Pinocchio01/AutoCAD/README.md

# AutoCAD
Some computer aided design(CAD) works collected.
