Pinocchio01/AutoCAD/机械设计实习/机械设计任务书-1551663-彭义超.docx

机械设计课程设计

计算说明书

设计题目 圆锥圆柱齿轮减速器

机械与能源工程学院

专业 机械莱茵 学号 1551663

设计人_______ _彭义超_________

指导教师_ _奚鹰教授__ _ __

2018年7月18日

装 订 线 | 设计计算及说明 | 主要结果

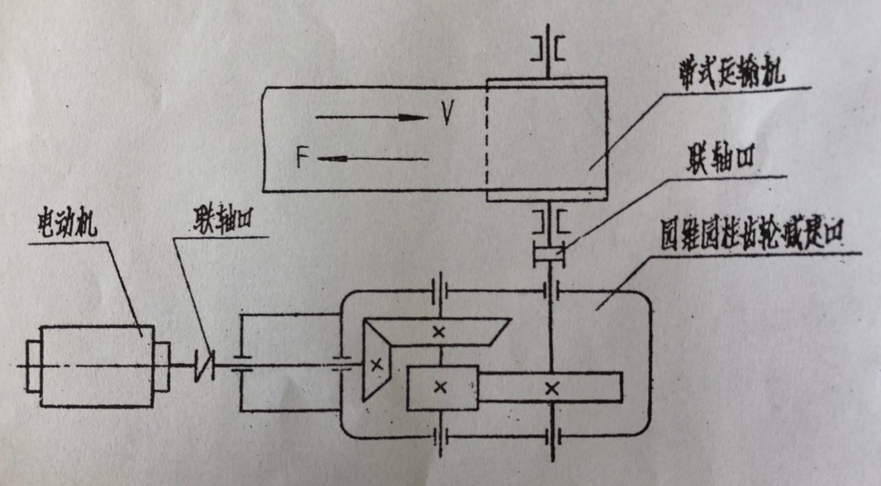
[picture p1: figure]

| 1 设计任务书 设计一个用于带式运输机上的圆锥圆柱齿轮减速器。总体布置简图如图 1.1所示。 图 1.1 总体布置简图 工作平稳、单向运转。所给原始数据如下表所示。 题号 运输带工作拉力F 运输带工作速度V 运输机卷筒直径D 带速允许偏差 使用期限 工作制度 3 2200 1.4 320 5 10 1 N m/s mm % 年 班/日 2 电动机选择 由所给定的条件可知，电动机选Y型。工作机主动轴的输出功率 P_ω =Fv=3.08kW 。根据运输带速度及卷筒的直径可知，输出转速为 n_w =(60×1000v_w)/(πD)=83.6 r/min 根据《机械设计课程设计》表 2-4，弹性联轴器、闭式圆柱齿轮传动、闭式圆锥齿轮传动、带式运输机以及滚动轴承的效率分别为0.99、0.97、0.95、0.99、0.95。所以电动机至工作机主动轴之间的总效率为 | P_ω =3.08 kW n_w =83.6 r/min

η_Σ =0.83 。所以电动机的输出功率为

P_d =(P_w)/(η_Σ)=3.71 kW

所以，选择电动机的型号为Y132M1-6。其额定功率为4 kW，满载转速为960 r/min。

电动机型号 | 额定功率 | 满载转速 | 额定转矩/ 额定转矩 | 最大转矩/ 额定转矩 | 质量
| 4 | 960 | 2.0 | 2.2 | 73
Y132M1-6 | kW | r/min | | | kg

# 3 传动比分配

由电动机的满载转速nm和工作机轴的转速nw可确定传动装置的总传动比为

i=(n_m)/(n_w)=i_1 i_2 =11.484

对于圆锥-圆柱齿轮减速器，为使大齿轮直径不致过大，高速级圆锥齿轮传动比取为

i_1 = 0.25i = 2.871 < 3，则两级圆柱齿轮传动的传动比为 i_2 =(i_Σ)/(i_1)=4 。定为： i_1 =2.8 , i_2 =4.1

由此，可以算出各轴的转速如下（以下标1表示输入轴的参数，下标2表示中间轴的参数，下标3表示输出轴的各参数）。

n_1 =n_m =960 r/min

n_2 =(n_1)/(i_1)=342.9 r/min

n_3 =(n_2)/(i_2)=83.6 r/min

各轴的功率如下。

P_1 =P_d η_01 =3.636 kW

P_2 =P_1 η_12 =3.420 kW

P_3 =P_2 η_23 =3.284 kW

各轴的输出转矩如下。

T_d =9550(P_d)/(n_m)=36.91 N∙m

T_1 =9550(P_1)/(n_1)=36.17 N∙m

T_2 =9550(P_2)/(n_2)=95.25 N∙m

T_3 =9550(P_3)/(n_3)=375.15 N∙m

计算结果汇总如下表所示。

项目 | 电动机轴 | | 1轴 | | 2轴 | | 3轴
转速 r/min | 960 | | 960 | | 342.9 | | 83.6
功率 kW | 11 | | 10.45 | | 10.04 | | 9.64
转矩 N∙m | 35.85 | | 68.12 | | 367.81 | | 1984.95
效率 | | 0.98 | | 0.94 | | 0.96

P_d =3.71 kW

P_(ed) =4 kW

n_m =960 r/min

i=11.484

i_1 =2.8

i_2 =4

n_1 =960r/min

n_2 =342.9r/min

n_3 =83.6r/min

P_1 =3.636kW

P_2 =3.420kW

P_3 =3.284kW

T_d =36.91N·m

T_1 =36.17N·m

T_2 =95.25N·m

T_3 =375.15N·m

# 4 齿轮的设计

## 4.1 斜齿圆柱齿轮的类型、精度等级、材料及齿数

低速齿轮传动选用斜齿圆柱齿轮传动，压力角取20°。带式输送机为一般工作机器，参考《机械设计》表 10-6，选用7级精度。由《机械设计》表 10-1，选择小齿轮材料为40Cr（调质），齿面硬度（265- 285）HBS，大齿轮材料为45钢（调质），齿面硬度（235- 255）HBS。选小齿轮齿数z1= 24，则大齿轮齿数z2= uz1= 98.4，取z2= 98。初选螺旋角 β=14° 。

## 4.2 按齿面接触疲劳强度计算

计算小齿轮的分度圆直径，即

d_(1t) ≥³√((2K_(Ht) T_1)/(ϕ_d)∙(u+1)/u∙((Z_H Z_E Z_ε Z_β)/([σ_H ]))^2)

确定公式中各参数的值如下。

①试选载荷参数 K_(Ht) =1.3 。

②由《机械设计》图 10-20查取区域系数 Z_H =2.433

③计算接触疲劳强度用重合度系数 Z_ε

α_t =arctan⁡(tanα_n /cosβ)=20.562°

α_(at1) =arccos[z_1 cosα_t /(z_1 +2h_(an)^(*) cosβ)]=29.974°

α_(at2) =arccos[z_2 cosα_t /(z_2 +2h_(an)^(*) cosβ)]=23.038°

ε_α =[z_1 (tanα_(at1) -tanα_t^(') )+z_2 (tanα_(at2) -tanα_t^(') )]/2π=1.552

ε_β =ϕ_d z_1 tanβ/π=2.096

Z_ε =√((4-ε_α)/3(1-ε_β )+(ε_β)/(ε_α))=0.675

④螺旋角系数

Z_β =√(cosβ)=0.985

⑤根据《机械设计》表 10-7选取齿宽系数 ϕ_d =1 .1

⑥根据《机械设计》表 10-5查得材料的弹性影响系数 Z_E =189.8 MPa^(1/2)

⑦计算接触疲劳需用应力 [σ_H ]

根据《机械设计》图 10-25d查得小齿轮和大齿轮的接触疲劳极限分别为 σ_(Hlim1) =600 MPa 、 σ_(Hlim2) =550 MPa 。

应力循环次数为

N_1 =60n_1 jL_h =4.939×10^8

N_2 =N_1 /u=1.2×10^8

由《机械设计》图 10-23查得接触疲劳寿命系数 K_(HN1) =0.93 、 K_(HN2) =0.97 。取失效概率为1%、安全系数S=1，所以

[σ_H ]_1 =(K_(HN1) σ_(Hlim1))/S=558 MPa

[σ_H ]_2 =(K_(HN2) σ_(Hlim2))/S=534 MPa

取 [σ_H ]_1 和 [σ_H ]_2 中的较小者作为该齿轮副的接触疲劳许用应力，即 [σ_H ]=534 Mpa 。

所以小齿轮分度圆直径 d_(1t) ≥48.088 mm 。

由此可得，圆周速度为

v=(πd_(1t) n_1)/(60×1000)=0.93 m/s

齿宽为

b=ϕ_d d_(1t) =52.896 mm

由《机械设计》表 10-2查得使用系数 K_A =1.25 ，根据圆周速度0.93m/s及7级精度，由图 10-8查得动载系数 K_v =1.03 ，齿轮的圆周力 F_(t1) =2T_1 /d_(1t) =3.962×10^3 N ， K_A F_(t1) /b=93.63 N/mm<100 N/mm ，查表 10-3得齿间载荷分布系数 K_(Hα) =1.4 。由表 10-4用外插法查得齿向载荷分布系数 K_(Hβ) =1.485 ，所以，载荷系数为

K_H =K_A K_v K_(Hα) K_(Hβ) =2.677

则按实际载荷系数算得的分度圆直径为

d_1 =d_(1t) ³√((K_H)/(K_(Ht)))=61.179 mm

相应的齿轮模数为

m_n =d_1 cosβ/z_1 =2.473 mm

4.3 按齿根弯曲强度设计

试算齿轮模数得

m_(nt) ≥³√((2K_(Ft) T_1 Y_ε Y_β cos^2 β)/(ϕ_d z_1^2)∙[(Y_(Fa) Y_(sa))/([σ_F ])])

①试选载荷系数 K_(Ft) =1.3

②计算弯曲疲劳强度的重合度系数 Y_ε

β_b =arctan(tanβcosα_t )=13.140°

ε_(αv) =ε_α /cos^2 β_b =1.637

Y_ε =0.25+0.75/ε_(αv) =0.708

③计算弯曲疲劳强度的螺旋角系数 Y_β

Y_β =1-ε_β β/(120°)=0.778

④计算 (Y_(Fa) Y_(sa))/([σ_F ])

由当量齿数

z_(v1) =z_1 /cos^3 β=26.27

z_(v2) =z_2 /cos^3 β=107.28

查《机械设计》图 10-17，得齿形系数 Y_(Fa1) = 2.62、 Y_(Fa2) =2.18 。由图 10-18查得应力修正系数 Y_(sa1) =1.6 、 Y_(sa2) = 1.81。由图 10-24c查得小齿轮和大齿轮的齿根弯曲疲劳极限分别为 σ_(Flim1) =500 MPa 、 σ_(Flim2) =380 MPa 。由图 10-22查得弯曲疲劳寿命系数 K_(FN1) =0.92 ， K_(FN2) =0.96 。取弯曲疲劳安全系数S=1.4，得

[σ_F ]_1 =(K_(FN1) σ_(Flim1))/S=328.57 MPa

[σ_F ]_2 =(K_(FN2) σ_(Flim2))/S=260.57 MPa

(Y_(Fa1) Y_(sa1))/([σ_F ]_1)=0.0128

(Y_(Fa2) Y_(sa2))/([σ_F ]_2)=0.0151

故取

(Y_(Fa) Y_(sa))/([σ_F ])=0.0151

所以齿轮模数 m_(nt) ≥1.453 mm 。

d_1 =m_(n1) z_1 /cosβ=35.940 mm

v=(πd_1 n_1)/(60×1000)=0.65 m/s

b=ϕ_d d_1 =39.534 mm

h=(2h_(an)^(*) +c_n^(*) )m_(nt) =3.269 mm

b/h=12.09

根据圆周速度及7级精度，由《机械设计》图 10-8，查得动载系数 K_v =1.01 ，由 F_(t1) =2T_1 /d_1 =5.203×10^3 N ， K_A F_(t1) /b=158.80 N/mm>100 N/mm ，查表 10-3得齿间载荷分配系数 K_(Fα) =1.2 ，由表 10-4查得齿向载荷分布系数 K_(Hβ) =1.370 ，结合b/h=12.09查图 10-13，得 K_(Fβ) =1.32 ，故载荷系数为

K_F =K_A K_v K_(Fα) K_(Fβ) =2.039

所以按实际载荷系数算得的齿轮模数为

m_n =m_(nt) ³√((K_F)/(K_(Ft)))=1.688 mm

对比计算结果，由齿面接触疲劳强度计算的法面模数mn大于由齿根弯曲疲劳强度计算的法面模数。从满足弯曲疲劳强度出发，从标准中就近取mn=2 mm；为了同时满足接触疲劳强度，需按接触疲劳强度算得的分度圆直径 d_1 =61.179 mm 来计算小齿轮的齿数，即 z_1 =d_1 cosβ/m_n =29.7 ，取 z_1 =29 ，则 z_2 =uz_1 =118.9 ，取 z_2 =119 ，z1与z2互为质数。

## 4.4 几何尺寸计算

①计算中心距

a=((z_1 +z_2 )m_n)/(2cosβ)=152.31 mm

考虑模数从1.688 mm增大圆整至2 mm，为此将中心距减小圆整为150 mm。

②按圆整后的中心距修正螺旋角

β=arccos((z_1 +z_2 )m_n)/(2a)=11.48°

③计算小、大齿轮的分度圆直径

d_1 =(z_1 m_n)/(cosβ)=59.18 mm

d_2 =(z_2 m_n)/(cosβ)=240.82 mm

④计算齿轮宽度

b=ϕ_d d_1 =65.1 mm

取 b_2 =65 mm 、 b_1 =70 mm 。

## 4.5 圆整中心距后的强度校核

### 4.5.1 齿面接触疲劳强度校核

σ_H =√((2K_H T_1)/(ϕ_d d_1^3)∙(u+1)/u)Z_H Z_E Z_ε Z_β

①计算载荷系数 K_H

取使用系数 K_A =1.25 ，由

v=(πd_1 n_1)/(60×1000)=1.06 m/s

以及7级精度，由《机械设计》图 10-8查得动载系数 K_v = 1.06，齿轮的圆周力 F_(t1) =2T_1 /d_1 =3.218×10^3 N ， K_A F_(t1) /b=57.46 N/mm<100 N/mm ，查表10-3得齿间载荷分配系数 K_(Hα) =1.4 ，由表 10-4得齿向载荷分布系数 K_(Hβ) =1.439 ，所以载荷系数为

K_H =K_A K_v K_(Hα) K_(Hβ) =2.67

②计算区域系数 Z_H

由《机械设计》图 10-20查得区域系数 Z_H =2.45

③计算弹性影响系数 Z_E

由《机械设计》表 10-5查得材料的弹性影响系数 Z_E =189.8 MPa^(1/2)

④计算重合度系数 Z_ε

α_t =arctan⁡(tanα_n /cosβ)=20.562°

α_(at1) =arccos⁡[z_1 cosα_t /(z_1 +2h_(an)^(*) cosβ)]=29.131°

α_(at2) =arccos⁡[z_2 cosα_t /(z_2 +2h_(an)^(*) cosβ)]=23.065°

ε_α =[z_1 (tanα_(at1) -tanα_t^(') )+z_2 (tanα_(at2) -tanα_t^(') )]/2π=1.67

ε_β =ϕ_d z_1 tanβ/π=0.989

Z_ε =√((4-ε_α)/3(1-ε_β )+(ε_β)/(ε_α))=0.65

⑤计算螺旋角系数 Z_β

Z_β =√(cosβ)=0.99

综上可得， σ_H =498.9 MPa<[σ_H ]=534 MPa ，故满足齿面接触疲劳强度条件。

### 4.5.2 齿根弯曲疲劳强度校核

σ_F =(2K_F T_1 Y_(Fa) Y_(sa) Y_ε Y_β cos^2 β)/(ϕ_d m_n^3 z_1^2)

①计算载荷系数 K_F

K_A =1.25 ， K_v =1.06 ，由《机械设计》表 10-3查得齿间载荷分配系数 K_(Fα) =1.4 ，结合 h=(2h_(an)^(*) +c_n^(*) )m_(nt) =4.5 mm ， b/h=14.4 ，查图 10-13得 K_(Fβ) =1.45 ，所以载荷系数

K_F =K_A K_v K_(Fα) K_(Fβ) =2.68

②计算齿形系数 Y_(Fa)

由当量齿数

z_(v1) =z_1 /cos^3 β=30.8

z_(v2) =z_2 /cos^3 β=125.4

查《机械设计》图 10-17，得齿形系数 Y_(Fa1) =2.54 ， Y_(Fa2) =2.17 。

③计算应力修正系数 Y_(sa)

由《机械设计》图 10-18查得应力修正系数 Y_(sa1) =1.63 ， Y_(sa2) =1.83 。

④计算重合度系数 Y_ε

β_b =arctan(tanβcosα_t )=10.766°

ε_(αv) =ε_α /cos^2 β_b =1.730

Y_ε =0.25+0.75/ε_(αv) =0.684

⑤计算螺旋角系数 Y_β

Y_β =1-ε_β β/(120°)=0.905

综上可得

σ_(F1) =(2K_F T_1 Y_(Fa1) Y_(sa1) Y_ε Y_β cos^2 β)/(ϕ_d m_n^3 z_1^2)=169.8MPa<[σ_F ]_1

σ_(F2) =(2K_F T_1 Y_(Fa2) Y_(sa2) Y_ε Y_β cos^2 β)/(ϕ_d m_n^3 z_1^2)=162.9 MPa<[σ_F ]_2

所以齿根弯曲疲劳强度满足要求。

## 4.6 高速级直齿圆锥齿轮的设计

### 4.6.1选定齿轮类型、精度等级、材料及齿数

选用标准圆锥直齿轮传动，压力角取 20° 。根据参考文献[2]表10-6，通用减速器取精度等级7级。

由参考文献[2]表10-1，选择小齿轮材料为40Cr（调质），齿面硬度2（265- 285）HBS，大齿轮材料为45钢（调质），齿面硬度为（235- 255）HBS。

选小齿轮齿数 z_1 =24 ,大齿轮齿数 z_2 =z_1 i_1 =24×2.8=67.2 , 取 z_2 =67 。

α=20°

z_1 =24

z_2 =98

β=14°

σ_(Hlim1) =600 MP a

σ_(Hlim2) =550 MPa

[σ_H ]=534 Mpa

v=0.93 m/s

b=52.896 mm

d_1 =61.179 mm

m_n =2.473 mm

m_n =2

z_1 =29

z_2 =119

a=152.31mm

β=11.48°

d_1 =59.18mm

d_2 =240.82mm

b_1 =70 mm

b_2 =65 mm

α=20°

z_1 =24

z_2 =67

### 4.6.2按齿面接触强度设计

试算小齿轮分度圆直径

d_(1t) ≥³√((4K_(Ht) T_1)/(∅_R (1-0.5∅_R )^2 i_1)∙((Z_H Z_E)/([σ_H ]))^2)

#### 4.6.2.1 确定公式中各参数

试选 K_(Ht) =1.3

T1=3.617×10^4 Nmm

取齿宽系数 ∅_R =0.3

由参考文献[2]图10-20查得区域系数 Z_H =2.5

由参考文献[2]表10-5查得材料的弹性影响系数 Z_E =189.8

由参考文献[2]图10-25d查得小齿轮和大齿轮的接触疲劳极限分别为 σ_(Hlim1) =600Mpa ， σ_(Hlim1) =550Mpa 。

计算应力循环次数

N_1 =60n_1 jL_h =60×960×1×(1×8×300×10)=1.3824×10^9

N_2 =(N_1)/(i_1)=(1.3824×10^9)/2.8=4.937×10^8

由参考文献[2]图10-23查取接触疲劳寿命系数 K_(HN1) =0.95 , K_(HN2) =0.97 。取失效概率为1%，安全系数 S=1

[σ_H ]_1 =(K_(HN1) σ_(Hlim1))/S=(0.92×650)/1=570Mpa

[σ_H ]_2 =(K_(HN2) σ_(Hlim2))/S=(0.98×600)/1=534Mpa

取其中较小者作为接触疲劳许用应力，即

[σ_H ]=[σ_H ]_2 =534Mpa

#### 4.6.2.2 试算小齿轮分度圆直径

d_(1t) ≥³√((4K_(Ht) T_1)/(∅_R (1-0.5∅_R )^2 i_1)∙[(Z_H Z_E)/([σ_H ])]^2)

=³√((4×1.3×3.617×10^4)/(0.3×(1-0.5×0.3)^2 ×(67/24))×((2.5×189.8)/534)^2)

=62.649 mm

#### 4.6.2.3调整小齿轮分度圆直径

圆周速度v

d_(m1) =d_(1t) (1-0.5∅_R )=62.649×(1-0.5×0.3)=53.252 mm

v_m =(πd_(m1) n_1)/(60×1000)=(π×53.252×960)/(60×1000)=2.677 m/s

[σ_H ]=534MPa

当量齿轮的齿宽系数 ∅_d

b=∅_R d_(1t) (√(i_1 ^2 +1))/2=0.3×62.694×(√((67/24)^2 +1))/2=27.887mm

∅_d =b/(d_(m1))=24.735/46.118=0.524

由参考文献[2]表10-2查得使用系数 K_A =1.25

由参考文献[2]图10-8查得动载系数 K_v =1.1

齿间载荷分配系数 K_(Hα) =1

由参考文献[2]表10-4用插值法查得齿向载荷分布系数 K_(Hβ) =1.28

可以计算得实际载荷系数

K_H =K_A K_v K_(Hα) K_(Hβ) =1.25×1.1×1×1.28=1.762

按实际载荷系数算得的分度圆直径为

d_1 =d_(1t) ³√((K_H)/(K_(Ht)))=62.649×³√(1.76/1.3)=69.322mm

相应的齿轮模数为

m=(d_1)/(z_1)=69.322/24=2.889mm

### 4.6.3按齿根弯曲疲劳强度计算

m≥³√((K_(Ft) T_1)/(∅_R (1-0.5∅_R )^2 z_1 ^2 √(i_1 ^2 +1))∙(Y_(Fa) Y_(Sa))/([σ_F ]))

#### 4.6.3.1确定公式中的各参数值

试选 K_(Ft) =1.3

由分锥角 δ_1 =arctan(1/u)=arctan(24/67)=19.708° 和 δ_2 =90°-19.708°=70.292° ，可得当量齿轮数 z_(v1) =(z_1)/(cos⁡(δ_1 ))=24/(cos⁡(19.708°))=25.49 ， z_(v2) =(z_2)/(cos⁡(δ_2 ))=67/(cos⁡(70.292°))=198.68

由参考文献[2]图10-17查得齿形系数 Y_(Fa1) =2.67 ， Y_(Fa2) =2.15 。由参考文献[2]图10-18查得应力修正系数 Y_(Sa1) =1.60 ， Y_(Sa2) =1.83 。由参考文献[2]图10-24c查得小齿轮和大齿轮的齿根弯曲疲劳极限分别为 σ_(Flim1) =500Mpa ， σ_(Flim2) =380Mpa 。由参考文献[2]图10-22查得弯曲疲劳寿命系数 K_(FN1) =0.88 ， K_(FN2) =0.90 。取弯曲疲劳安全系数S=1.7，可得

[σ_F ]_1 =(K_(FN1) σ_(Flim1))/S=(0.88×500)/1.7=258.8Mpa

[σ_F ]_2 =(K_(FN2) σ_(Flim2))/S=(0.90×380)/1.7=201.2Mpa

(Y_(Fa1) Y_(Sa1))/([σ_F ]_1)=(2.67×1.60)/258.824=0.0165

(Y_(Fa2) Y_(Sa2))/([σ_F ]_2)=(2.15×1.83)/201.176=0.0194

因为大齿轮 (Y_(Fa2) Y_(Sa2))/([σ_F ]_2) 大于小齿轮，所以取

(Y_(Fa) Y_(Sa))/([σ_F ])=(Y_(Fa2) Y_(Sa2))/([σ_F ]_2)=0.0194

#### 4.6.3.2试算模数

m≥³√((K_(Ft) T_1)/(∅_R (1-0.5∅_R )^2 z_1 ^2 √(i_1 ^2 +1))∙(Y_(Fa) Y_(Sa))/([σ_F ]))

=³√((1.3×3.452×10^4)/(0.3×(1-0.5×0.3)^2 ×23^2 √(2.87^2 +1))×0.0196)

=1.351

#### 4.6.3.3调整齿轮模数

圆周速度v

d_1 =m_1 z_1 =1.351×24=34.424mm

d_(m1) =d_1 (1-0.5∅_R )=34.424×(1-0.5×0.3)=27.560 mm

v_m =(πd_(m1) n_1)/(60×1000)=(π×27.560×960)/(60×1000)=1.385m/s

齿宽b

b=∅_R d_1 (√(u^2 +1))/2=0.3×34.424×(√(2.8^2 +1))/2=14.422 mm

由参考文献[2]图10-8查得动载系数 K_v =1.05 ，齿间载荷分配系数 K_(Fα) =1 ，由参考文献[2]表10-4用插值法得出 K_(Hβ) =1.280 ， K_(Fβ) =1.280 。则载荷系数为

K_F =K_A K_v K_(Fα) K_(Fβ) =1.25×1.05×1×1.280=1.680

可得按实际载荷系数算得的齿轮模数为

m=m_t ³√((K_F)/(K_(Ft)))=1.351×³√(1.680/1.3)=1.472mm

按照齿根弯曲疲劳强度计算的模数，就近选择标准模数 m=2mm ，按照接触疲劳强度算得的分度圆直径 d_1 =69.322mm ，算出小齿轮齿数 z_1 =(d_1)/m=69.322/2=34.67 。取 z_1 =35 ，则大齿轮齿数 z_2 =i_1 z_1 =2.8×35=98 。为了使两齿轮齿数互质，取 z_2 =99 .

### 4.6.4几何尺寸计算

#### 4.6.4.1计算分度圆直径

d_1 =z_1 m=35×2=70 mm

d_2 =z_2 m=99×2=198 mm

#### 4.6.4.2计算分锥角

δ_1 =arctan(1/i)=arctan(35/99)=19°28'13''

δ_2 =90°-δ_1 =70°31'47''

#### 4.6.4.3计算齿轮宽度

b=∅_R d_1 (√(i_1 ^2 +1))/2=0.3×70×(√((99/35)^2 +1))/2=31.5mm

取 b_1 =b_2 =32 mm

### 4.6.5主要设计结论

小齿轮齿数 大齿轮齿数 模数 压力角 变位系数 分锥角 齿宽 其他要求 | z_1 =35 z_2 =99 m=2 mm α=20° x_1 =0 x_2 =0 δ_1 =19°28'13'' δ_2 =70°31'47'' b_1 =b_2 =32 mm 小齿轮选用40Cr（调制），大齿轮选用45钢（调制）。齿轮按7级精度设计

### 4.6.6 其他技术要求

铸造、焊接或烧结的带轮边缘、腹板、轮辐及轮毂上不允许有砂眼、裂缝、缩孔及气泡；铸造带轮在不提高内部应力的前提下，允许对轮缘、凸台、腹板及轮毂的表面缺陷进行修补。

m=2mm

z_1 =35

z_2 =99

d_1 =70mm

d_2 =198mm

b=31.5mm

| 5 轴的设计 5.1 最小直径的确定 5.1.1 输入轴 输入轴的材料选择为45钢，所以输入轴最小直径为 d_(1min) ≥A_0 ³√((P_1)/(n_1))=19.4 mm 由于轴上开有键槽，应增大轴径以考虑键槽对轴的强度的削弱，所以最小直径应增大为 (1+10%)d_(1min) =21.34 mm 。取输入轴的最小直径为22 mm。 5.1.2 中间轴 中间轴的材料选择为45钢，所以中间轴最小直径为 d_(2min) =A_0 ³√((P_2)/(n_2))=26.8 mm 由于轴上开有键槽，应增大轴径以考虑键槽对轴的强度的削弱，所以最小直径应增大为 (1+7%)d_(2min) =28.68 mm 。考虑轴与轴承的配合，取中间轴的最小直径为29 mm。 5.1.3 输出轴 输出轴的材料选择为45钢，所以输出轴最小直径为 d_(3min) =A_0 ³√((P_3)/(n_3))=42.3 mm 由于轴上开有键槽，应增大轴径以考虑键槽对轴的强度的削弱，所以最小直径应增大为 (1+15%)d_(3min) =48.69 mm 。考虑轴与联轴器的配合，取输出轴的最小直径为49 mm。 5.2 确定润滑方式 浸油齿轮圆周速度为 v=(πnd)/(60×1000)=3.63 m/s≥1.5~2 m/s 所以应采用油润滑，飞溅油可以形成油雾。 | d_(1min) =21 mm d_(2min) =29 mm d_(3min) =49 mm

装 订 线 | 设计计算及说明 | 主要结果

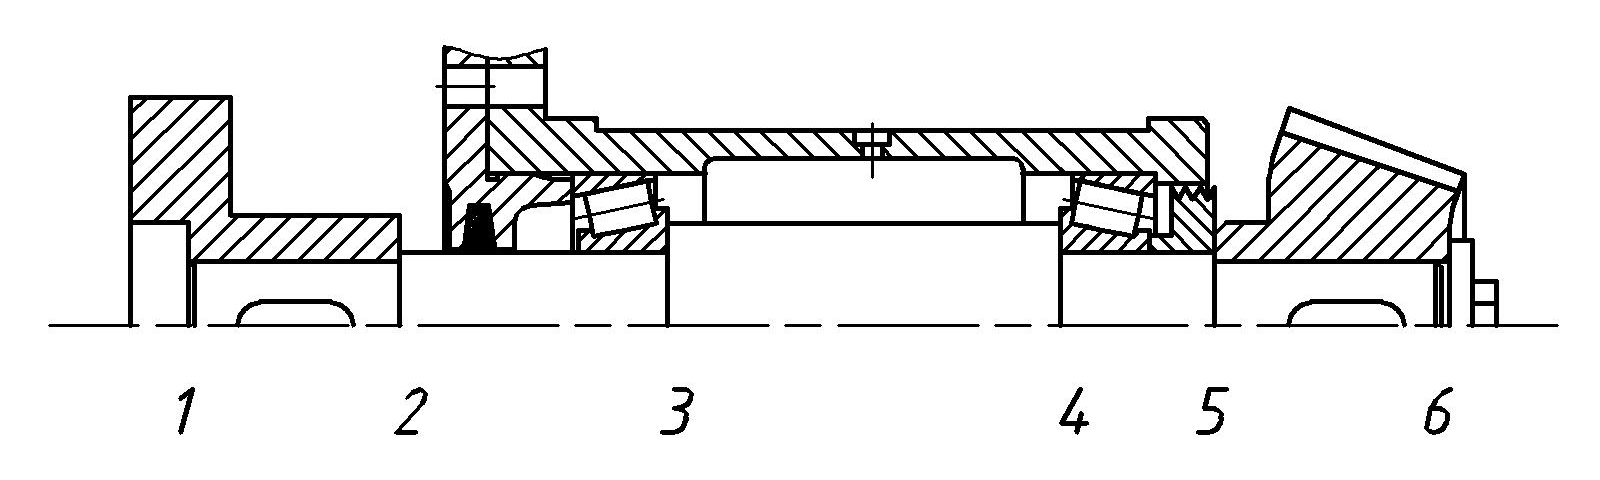
[picture p2: figure]
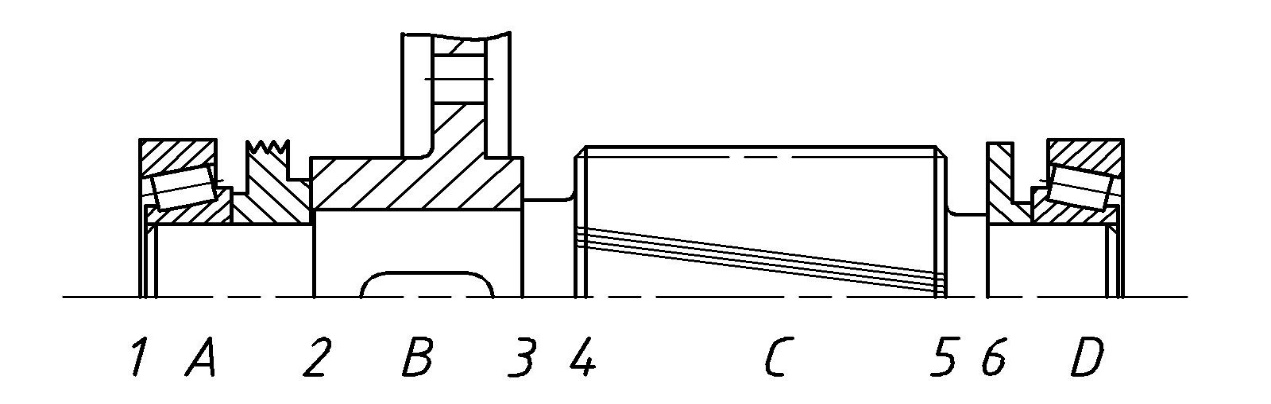
[picture p3: figure]

| 5.3 输入轴尺寸结构设计 图 5.1 输入轴结构示意图 输入轴结构如图 5.1所示， 轴段1-2上安装联轴器，联轴器根据计算转矩 T_(ca) =K_A T_(dI) =1.3×3.691×10^4 =47983N∙mm 选定LM4型梅花型弹性联轴器，其半联轴器孔径为 d_1 =22mm ，半联轴器长度 L=52mm 。取 d_(1-2) =22mm 。 轴段2-3左侧轴肩处相邻两段直径变化仅为区分加工表面，方便装拆，并起轴向定位作用，不承担轴向力，故取 d_(2-3) =25mm 。轴段2-3与轴承配合，选用圆锥滚子轴承30205。左侧滚动轴承用轴承端盖定位，需留有检修空间，使轴承端盖左侧与半联轴器留出约40mm间隙。 轴段3-4要形成轴肩以给轴承轴向定位，同时又要方便拆卸，故取 d_(3-4) =30mm 。 轴段4-5和右侧轴承配合，取 d_(4-5) =25mm 。 轴段5-6左侧应形成轴肩以给锥齿轮轴向定位，取 d_(5-6) =22mm 。 选用套杯使整体结构紧凑，用螺钉在轴右侧起紧定作用。 轴段 1-2 2-3 3-4 4-5 5-6 直径 22 25 30 25 22 长度 50 5 5 63 12 5.4 中间轴尺寸结构设计 图 5.2 中间轴结构示意图 | 滚动轴承30205

中间轴的最小直径为29 mm，所以选择圆锥滚子轴承30206，轴段1-2要与轴承配合，所以取 d_(1-2) =25mm ，并且需要为挡油盘留出空间，所以其长度为32 mm。轴承配合处和装挡油盘处的加工粗糙度应有区别。

轴段2-3左侧应形成定位轴肩，且轴肩承受径向力，所以轴段2-3的直径为 d_(2-3) =36mm ，与齿轮配合，长度略小于锥齿轮的宽度，故长度取为40 mm。

轴段3-4左侧形成定位轴肩，取 d_(3-4) =40mm 。旋转零件之间的轴向距离至少为10 mm，

故取长度为10 mm。

轴段4-5作为齿轮轴，斜齿圆柱齿轮分度圆直径为58 mm，轴段4-5长度为70 mm。

轴段5-6右侧形成定位轴肩，且齿轮端面到箱体内壁的距离应大于10 mm，所以轴段5-6的直径为 d_(5-6) =34mm ，长度为8 mm。

轴肩6-7与轴承30206配合，其直径为 d_(6-7) =30mm ，长度为25 mm。

轴段 | 1-2 | 2-3 | 3-4 | 4-5 | 5-6 | 6-7
直径 | 25 | 36 | 40 | 58 | 34 | 30
长度 | 32 | 40 | 10 | 70 | 8 | 25

## 5.5 输出轴尺寸结构设计

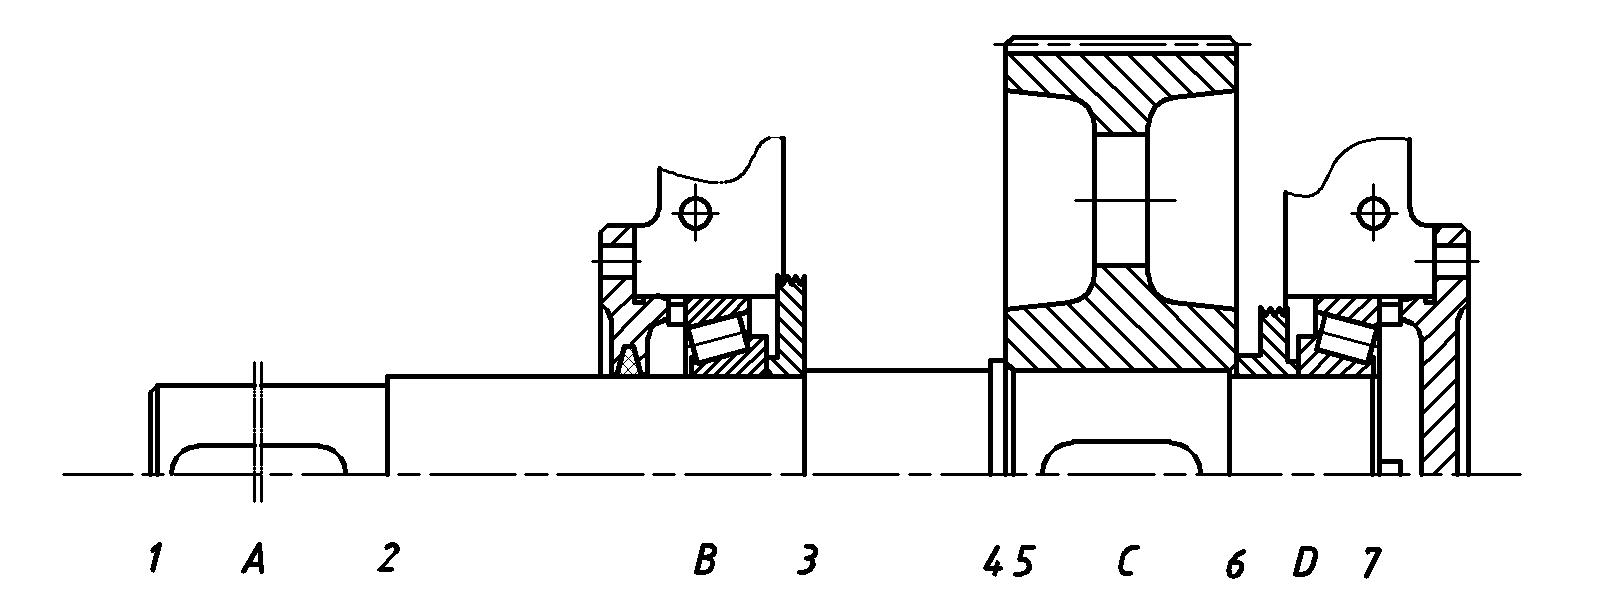
[picture p4: figure]

图 5.3 输出轴结构示意图

轴段1-2与联轴器配合，根据《机械设计》表 14-1，带式运输机的工作情况系数为1.3，所以联轴器的计算转矩为 T_(ca) =K_A T=470613 N∙m ，并且输出轴的最小直径为49 mm，所以选用LM7梅花型弹性联轴器，轴孔直径为50 mm，为保证联轴器的可靠轴向定位，令轴段1-2的直径为 d_(1-2) =50mm ，长度为82 mm，略短于半联轴器轴孔长度84 mm。

轴段2-3与轴承配合，选用圆锥滚子轴承30211，且要给轴承检修空间，故轴段2-3的直径为 d_(2-3) =55mm ，长度为118 mm。

轴段3-4保证旋转零件之间轴向零件距离，故轴段3-4的直径为 d_(3-4) =58mm ，长度为52 mm。

滚动轴承30206

梅花型弹性联轴器LM7

滚动轴承30211

装 订 线 | 设计计算及说明 | 主要结果
| 轴肩4-5用于齿轮的定位，所以轴段4-5的直径为 d_(4-5) =64mm ，长度为5 mm。 轴段5-6与齿轮配合，所以轴段5-6的直径为 d_(5-6) =58mm ，长度为63 mm。 轴段6-7与轴承配合，取6-7直径为 d_(6-7) =55mm ，长度为42 mm。 轴段 1-2 2-3 3-4 4-5 5-6 6-7 直径 50 55 58 64 58 55 长度 82 118 52 5 63 42 5.6 轴上键的选择及校核 5.6.1 输入轴 根据输入轴的直径及轮毂的宽度，选择输入轴轴段1-2键为 8×7×20 ，材料为钢，载荷性质为轻微冲击。校核过程如下 σ_p =(4000T)/(hld)=47.45 MPa<[σ_p ]=100MPa 可知该键安全。选择轴段5-6的键为 8×7×20 ，校核过程如下 σ_p =(4000T)/(hld)=41.34 MPa<[σ_p ] 可知该键也安全。 5.6.2 中间轴 根据中间轴的直径及轮毂的宽度，选择中间轴轴段2-3的键为12×8×25，校核过程如下 σ_p =(4000T)/(hld)=52.91 MPa 可知该键安全。 5.6.3 输出轴 根据输出轴的直径及轮毂的宽度，选择输出轴的轴段1-2的键为16×10×50，校核过程如下 σ_p =(4000T)/(hld)=60.02 MPa>[σ_p ] 可知该键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 | 键8×7×20 键8×7×20 键12×8×25 键16×10×50 键18×11×45

| 5.7 轴承寿命的校核 5.7.1 计算各齿轮上的受力 ①输入轴上的锥齿轮 输入轴上的小齿轮的圆周力、径向力、轴向力分别为 F_t =(2T)/(d_1)=1220 N F_r =F_t (tanα_n)/(cosβ)=419 N F_a =F_t tanβ=148 N ②中间轴上的锥齿轮 中间轴上的大齿轮的圆周力、径向力、轴向力分别为 F_t =(2T)/(d_2)=1208 N F_r =F_t (tanα_n)/(cosβ)=415 N F_a =F_t tanβ=146 N ③中间轴上的斜齿圆柱齿轮 中间轴上的小齿轮的圆周力、径向力、轴向力分别为 F_t =(2T)/(d_1)=3280 N F_r =F_t (tanα_n)/(cosβ)=1220 N F_a =F_t tanβ=670 N ④输出轴上的大齿轮 输出轴上的大齿轮的圆周力、径向力、轴向力分别为 F_t =(2T)/(d_2)=3214 N F_r =F_t (tanα_n)/(cosβ)=1196 N F_a =F_t tanβ=657 N | F_t =1220 N F_r =419 N F_a =148 N F_t =1208 N F_r =415 N F_a =146 N F_t =3280 N F_r =1220 N F_a =670 N F_t =3214 N F_r =1196 N F_a =657 N

装 订 线 | 设计计算及说明 | 主要结果

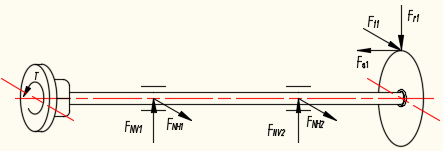
[picture p5: figure]

| 5.7.2 校核30205 轴承30205的额定动载荷 C_r =32.2 kN ，基本额定静载荷 C_(0r) =37.0 kN 。对输入轴受力分析图如下 图 5.4 输入轴受力分析 在H平面，对D点取力矩平衡得 F_(NH1) L_(BD) +F_(NH2) L_(CD) =0 又有 F_(NH1) +F_(NH2) =F_(t1) 得 F_(NH1) =810 N , F_(NH2) =-2030 N 。 在V平面内，对D点取力矩平衡得 F_(NV1) L_(BD) +F_(NV2) L_(CD) =F_(a1) 58.5/2 又有 F_(NV1) +F_(NV2) =F_(r1) 得 F_(NV1) =-220 N ， F_(NV2) =640 N ，所以， F_(r1) =√(F_(r1H)^2 +F_(r1V)^2)=840 N F_(r2) =√(F_(r2H)^2 +F_(r2V)^2)=2130 N 由此可得派生轴向力为 F_(d1) =eF_(r1) =310 N F_(d2) =eF_(r2) =790 N 因为 F_(d2) +F_a >F_(d1) ，所以左端轴承被压紧，右端轴承被放松，故 F_(a2) =F_(d2) =310 N ， F_(a1) =F_(d2) +F_a =940 N 。因为 (F_(a1))/(F_(r1))=1.2>e ，所以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

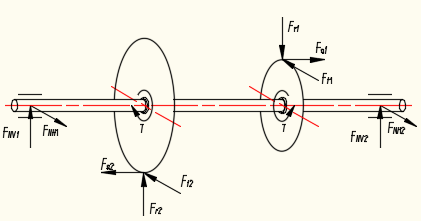
[picture p6: figure]

| L_h^(') =(10^6)/(60n)((f_t C)/P)^ε =2.3×10^5 h=98年 远大于检修间隔时间，所以轴承30205校核合格。 5.7.3 校核30206 轴承30206基本额定动载荷 C_r =43.2 kN ，基本额定静载荷 C_(0r) =50.5 kN 。对中间轴受力分析如下。 图 5.5 中间轴受力分析 同5.7.2，在N和H平面上分别进行受力分析，得 F_(NH1) =2050 N , F_(NH2) =2450 N F_(NV1) =40 N ， F_(NV2) =1040 N 故合成径向力 F_(r1) =√(F_(r1H)^2 +F_(r1V)^2)=2050 N F_(r2) =√(F_(r2H)^2 +F_(r2V)^2)=2670 N 所以派生轴向力为 F_(d1) =eF_(r1) =760 N F_(d2) =eF_(r2) =980 N 因为 F_(d1) +F_a^(') <F_(d2) ，所以上端轴承被压紧，下端轴承被放松，所以 F_(a2) =F_(d2) =980 N ， F_(a1) =F_(d1) +F_a^(') =860 N 。因为 F_(a1) /F_(r1) =0.42>e ，所以 P_1 =f_d (0.4F_(r1) +YF_(a1) )=2196 N 。因为 F_(a2) /F_(r2) =0.36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 | L_h^(') =2.3×10^5 h L_h^(') =1.86×10^5 h

装 订 线 | 设计计算及说明 | 主要结果

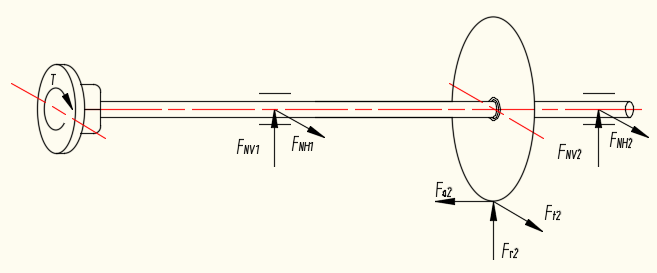
[picture p7: figure]

| 5.7.4 校核30211 轴承30211的基本额定动载荷 C_r =154 kN ，基本额定静载荷 C_(0r) =190 kN 。输出轴的受力分析如下图所示。 图 5.6 输出轴受力分析 同5.7.2，在N和H平面上分别进行受力分析，得 F_(NH1) =2050 N , F_(NH2) =2450 N F_(NV1) =40 N ， F_(NV2) =1040 N 故合成径向力 F_(r1) =√(F_(r1H)^2 +F_(r1V)^2)=2050 N F_(r2) =√(F_(r2H)^2 +F_(r2V)^2)=2670 N 所以派生轴向力为 F_(d1) =eF_(r1) =760 N F_(d2) =eF_(r2) =980 N 因为 F_(d1) <F_a +F_(d2) ，所以上端轴承被压紧，下端轴承被放松，所以 F_(a1) =F_a +F_(d2) =1560 N ， F_(a2) =F_(d2) =890 N 。因为 F_(a1) /F_(r1) =1.1>e ，所以 P_1 =f_d (XF_(r1) +YF_(a1) )=2910 N 。因为 F_(a2) /F_(r2) ≤e ，所以 P_2 =f_d F_(r2) =2220 N ，所以寿命为 L_h^(') =(10^6)/(60n)((f_t C)/P)^ε =1.66×10^6 h=690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 | L_h^(') =1.66×10^6 h

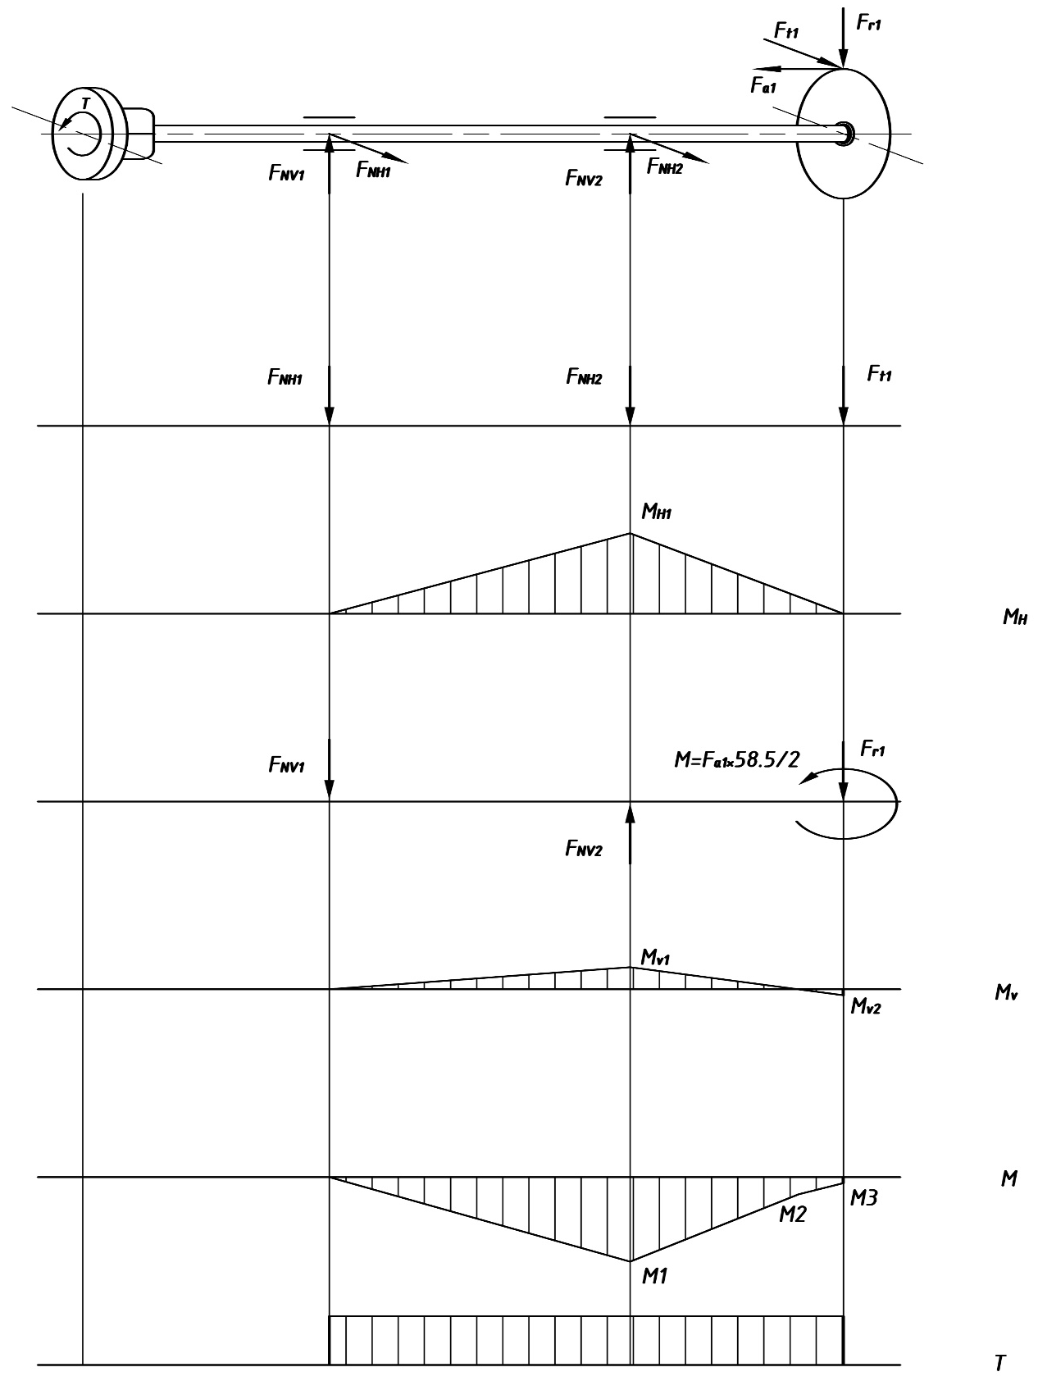
[picture p8: figure]

| 5.8 按弯扭合成应力校核轴的强度 5.8.1 输入轴的校核 图 5.7 输入轴弯矩图、扭矩图

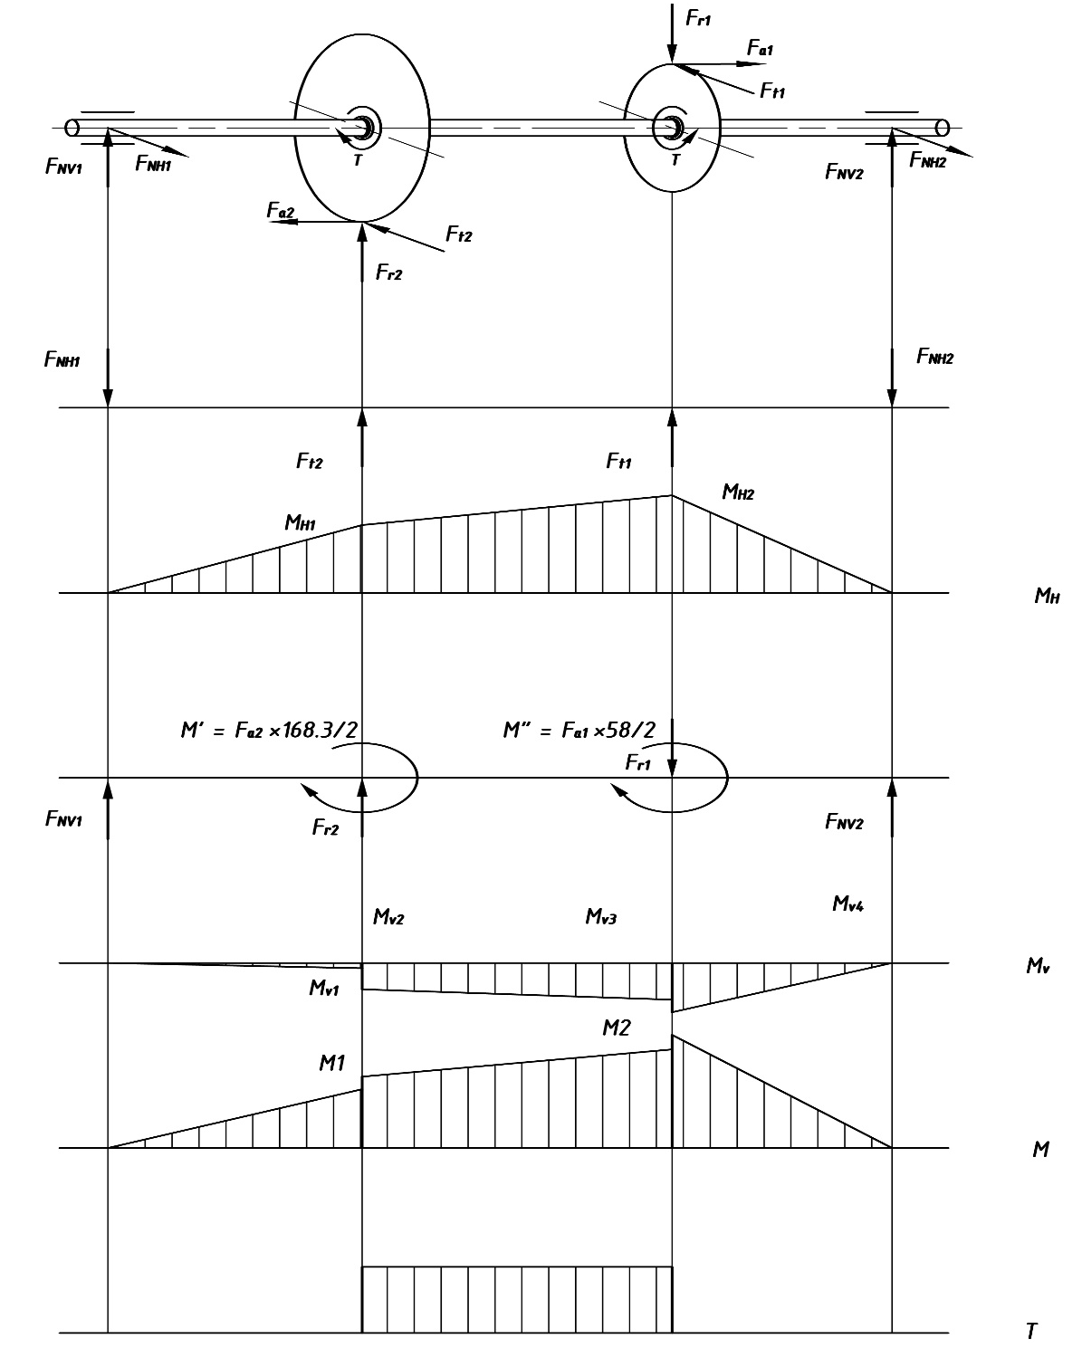
[picture p9: figure]
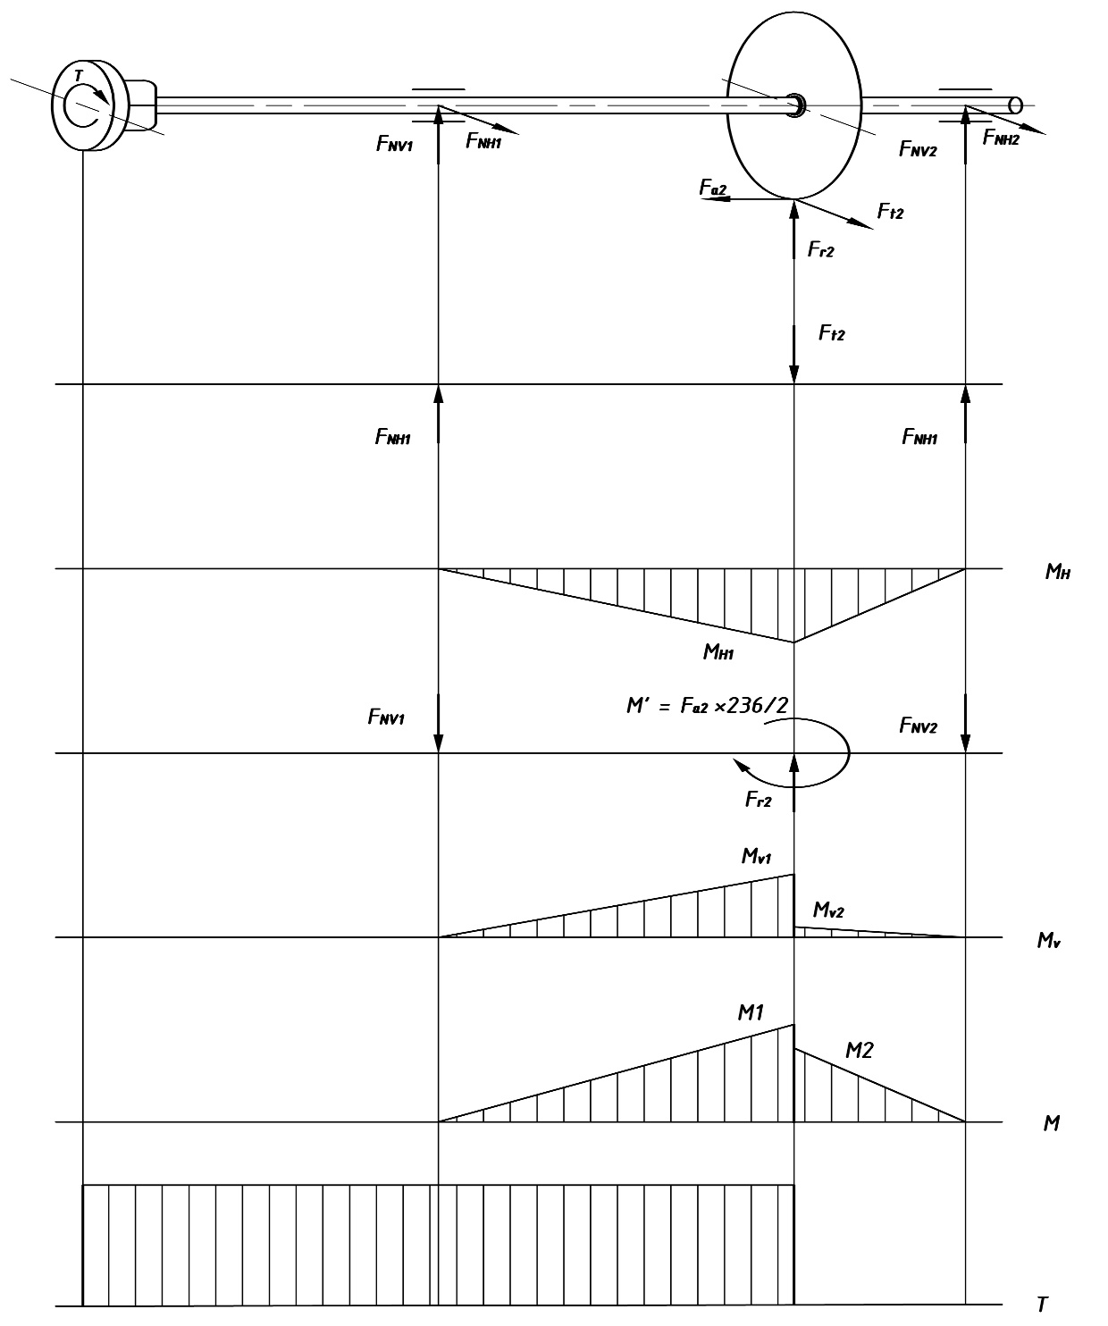
[picture p10: figure]

| 输入轴材料为45钢，调质处理。 根据之前的受力分析做出输入轴的弯矩图和扭矩图，经分析，右侧滚动轴承处弯矩及扭矩最大，为危险截面，此处弯矩 M=62.95 N∙m ，扭矩为 T=36.3 N∙m ，则轴的计算应力为 σ_(ca) =(√(M^2 +(αT)^2))/W=(32√(M^2 +(αT)^2))/(πd^3)=24.67 MPa<[σ_(-1) ]=60 MPa 所以中间轴安全。 5.8.2 中间轴的校核 图5.8 中间轴弯矩图、扭矩图 图5.8 中间轴弯矩图、扭矩图 中间轴设计成齿轮轴，故轴和齿轮材料同选为40Cr，调质处理。 根据之前的受力分析做出中间轴的弯矩图和扭矩图，经分析，小齿轮处弯矩及扭矩最大，为危险截面，此处弯矩 M=160 N∙m ，扭矩为 T=100 N∙m ，则轴的计算应力为 σ_(ca) =(√(M^2 +(αT)^2))/W=(32√(M^2 +(αT)^2))/(πd^3)=26.7 MPa<[σ_(-1) ]=70 MPa 所以中间轴安全。 5.8.3 输出轴校核 图 5.9 输出轴弯矩图扭矩图 | σ_(ca) =24.67 MPa σ_(ca) =26.7MPa

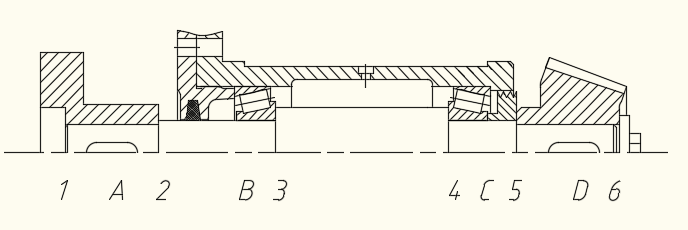
[picture p11: figure]

| 输出轴选用45钢，调质处理。 根据之前的受力分析，画出输出轴的弯矩图及扭矩图。经分析，大齿轮处弯矩及扭矩最大，为危险截面，此处弯矩 M=147.5 N∙m ，扭矩为 T=375 N∙m ，则轴的计算应力为 σ_(ca) =(√(M^2 +(αT)^2))/W=(√(M^2 +(αT)^2))/((πd^3)/32-(bt(d-t)^2)/d)=29.79 MPa<[σ_(-1) ]=60MPa 所以输出轴安全。 5.9 精确校核轴的疲劳强度 5.9.1 输入轴的精确校核 图 5.9 输入轴截面分析 从应力集中对轴的疲劳强度的影响来看，截面B、C、D处过盈配合引起的应力集中最严重；从受载的情况来看，右侧轴承截面C上的应力最大。截面B、C的应力集中的影响相近，但截面B受力较小，C截面已经校核安全且安全系数很大，故不必对B和5截面左侧做强度校核。5截面右侧有过盈配合，且应力较大，故对5截面右侧进行精确校核。 5.9.1.1 危险截面的右侧（尺寸突变） 抗弯截面系数 W=(πd^3)/32=1064 .8mm^3 抗扭截面系数 W_T =(πd^3)/16=2129.6 mm^3 截面5右侧的弯矩为 M=33500 N∙mm ，所以截面上的弯曲应力为 σ_b =M/W=31.48 MPa 截面上的扭转切应力为 τ_T =T/(W_T)=17.05 MPa 轴的材料为45钢， 调质处理。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 | σ_(ca) =29.79 MPa

装 订 线 | 设计计算及说明 | 主要结果

截面上由于轴肩而形成的理论应力集中系数 α_σ 及α_τ 按附表3-2查取。因 r/d=0.045 、 D/d=1.23 ，经插值后可查得

α_σ =2.30，α_τ =1.61

又由附图3-1可得轴的材料敏性系数为

q_σ =0.75，q_τ =0.77

故有效应力集中系数为

k_σ =1+q_σ (α_σ -1)=1.97

k_τ =1+q_τ (α_τ -1)=1.47

由附图3-2得尺寸系数 ε_σ =1.0 ；由附图3-3得扭转尺寸系数 ε_τ =0.95 。

轴按磨削加工，由附图3-4得表面质量系数为

β_σ =β_τ =0.93

轴未经表面强化处理，即 β_q =1 ，则得到综合系数为

K_σ =(k_σ)/(ε_σ)+1/(β_σ)-1=2.05

K_τ =(k_τ)/(ε_τ)+1/(β_τ)-1=1.62

对碳钢， φ_σ ≈0.1~0.2 ，取 φ_σ =0.1 ， φ_τ ≈0.05~0.1 ，取 φ_τ =0.05 ，于是，计算安全系数 S_(ca) 值

S_σ =(σ_(-1))/(K_σ σ_a +φ_σ σ_m)=4.27

S_τ =(τ_(-1))/(K_τ τ_a +φ_τ τ_m)=10.98

S_(ca) =(S_σ S_τ)/(√(S_σ^2 +S_τ^2))=3.98>S=1.5

故可知输入轴安全。

### 5.9.2 中间轴的精确校核

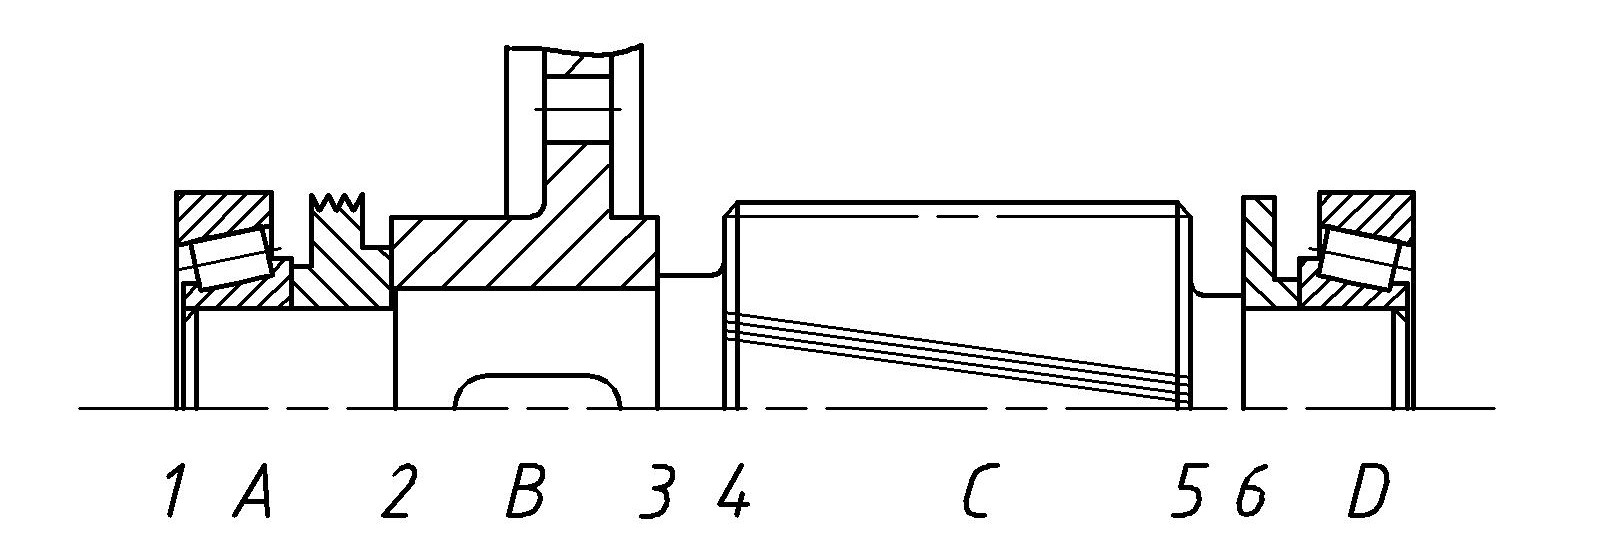
[picture p12: figure]

如图，从应力集中对轴的疲劳强度的影响来看，截面A、B、D处过盈配合引起的应力集中最严重；从受载的情况来看，右侧轴承截面C上的应力最大。截面A、D的应力集中的影响相近，两截面均不承受扭矩和弯矩。截面4、5截面尺寸变化造成的应力集中影响相近， 4截面受应力较大，故对4截面左侧轴肩进行校核。截面3左侧所受应力较大，且过盈配合，故对3截面左侧进行精确校核。

#### 5.9.2.1 危险截面4的左侧（尺寸突变）

抗弯截面系数

W=(πd^3)/32=6400 mm^3

抗扭截面系数

W_T =(πd^3)/16=12800 mm^3

截面4左侧的弯矩为 M=123800 N∙mm ，所以截面上的弯曲应力为

σ_b =M/W=19.34 MPa

截面上的扭转切应力为

τ_T =T/(W_T)=7.81 MPa

轴的材料为45钢， 调质处理（若45钢校核合格，则用40Cr也安全）。由 《机械设计》表15-1查得 σ_B =640 MPa ， σ_(-1) =275 MPa ， τ_(-1) =155 MPa 。

截面上由于轴肩而形成的理论应力集中系数 α_σ 及α_τ 按附表3-2查取。因 r/d=0.040 、 D/d=1.45 ，经插值后可查得

α_σ =2.19，α_τ =1.80

又由附图3-1可得轴的材料敏性系数为

q_σ =0.76，q_τ =0.82

故有效应力集中系数为

k_σ =1+q_σ (α_σ -1)=1.90

k_τ =1+q_τ (α_τ -1)=1.66

由附图3-2得尺寸系数 ε_σ =0.75 ；由附图3-3得扭转尺寸系数 ε_τ =0.86 。

轴按磨削加工，由附图3-4得表面质量系数为

β_σ =β_τ =0.92

轴未经表面强化处理，即 β_q =1 ，则得到综合系数为

K_σ =(k_σ)/(ε_σ)+1/(β_σ)-1=2.62

K_τ =(k_τ)/(ε_τ)+1/(β_τ)-1=2.02

对碳钢， φ_σ ≈0.1~0.2 ，取 φ_σ =0.1 ， φ_τ ≈0.05~0.1 ，取 φ_τ =0.05 ，于是，计算安全系数 S_(ca) 值

S_σ =(σ_(-1))/(K_σ σ_a +φ_σ σ_m)=5.43

S_τ =(τ_(-1))/(K_τ τ_a +φ_τ τ_m)=19.2

S_(ca) =(S_σ S_τ)/(√(S_σ^2 +S_τ^2))=5.23>S=1.5

故4截面左侧校核安全。

#### 5.9.2.2 危险截面3的左侧（过盈配合）

抗弯截面系数

W=(πd^3)/32=19511.2 mm^3

抗扭截面系数

W_T =(πd^3)/16=39022.4 mm^3

截面3左侧的弯矩为 M=115.1N∙mm ，所以截面上的弯曲应力为

σ_b =M/W=6.35 MPa

截面上的扭转切应力为

τ_T =T/(W_T)=2.56 MPa

过盈配合处的 (k_σ)/(ε_σ) ，由附表3-8用插值法求出，并取 (k_τ)/(ε_τ)=0.8(k_σ)/(ε_σ) ，于是得

(k_σ)/(ε_σ)=4.03，(k_τ)/(ε_τ)=3.22

轴按磨削加工，由附图3-4查得表面质量系数为

β_σ =β_τ =0.90

故可得综合系数为

K_σ =(k_σ)/(ε_σ)+1/(β_σ)-1=4.14

K_τ =(k_τ)/(ε_τ)+1/(β_τ)-1=3.33

所以轴在截面4左侧的安全系数为

S_σ =(σ_(-1))/(K_σ σ_a +φ_σ σ_m)=13.5

S_τ =(τ_(-1))/(K_τ τ_a +φ_τ τ_m)=45.6

S_(ca) =(S_σ S_τ)/(√(S_σ^2 +S_τ^2))=12.94>S=1.5

故可知中间轴安全。6.9.2中，对中间轴校核按45钢调质校核安全，而中间轴用强度更高的40Cr调质，故安全。

S_(ca) =3.98

S_(ca) =5.23

S_(ca) =12.94

### 5.9.3 输出轴的精确校核

如图，从应力集中对轴的疲劳强度的影响来看，截面B、C、D处过盈配合引起的应力集中最严重；从受载的情况来看，右侧轴承截面C上的应力最大。由于C截面按弯扭校核的安全系数较大，故考虑其两侧。截面B弯矩为0，截面D扭矩为0，故相对安全。故对应力较大且有过盈配合的截面5右侧和有尺寸突变的截面5左侧进行精确校核。

5.9.3.1 输出轴截面5左侧精确校核（尺寸突变）

抗弯截面系数

W=(πd^3)/32=19511.2 mm^3

抗扭截面系数

W_T =(πd^3)/16=39022.4 mm^3

截面5左侧的弯矩为 M=101400 N∙mm ，所以截面上的弯曲应力为

σ_b =M/W=5.20MPa

截面上的扭转切应力为

τ_T =T/(W_T)=7.15 MPa

轴的材料为45钢， 调质处理。由 《机械设计》表15-1查得 σ_B =640 MPa ， σ_(-1) =275 MPa ， τ_(-1) =155 MPa 。

截面上由于轴肩而形成的理论应力集中系数 α_σ 及α_τ 按附表3-2查取。因 r/d=0.034 、 D/d=1.1 ，经插值后可查得

α_σ =2.04，α_τ =1.34

又由附图3-1可得轴的材料敏性系数为

q_σ =0.80，q_τ =0.83

故有效应力集中系数为

k_σ =1+q_σ (α_σ -1)=1.83

k_τ =1+q_τ (α_τ -1)=1.28

由附图3-2得尺寸系数 ε_σ =0.68 ；由附图3-3得扭转尺寸系数 ε_τ =0.82 。

轴按磨削加工，由附图3-4得表面质量系数为

β_σ =β_τ =0.92

轴未经表面强化处理，即 β_q =1 ，则得到综合系数为

K_σ =(k_σ)/(ε_σ)+1/(β_σ)-1=2.78

K_τ =(k_τ)/(ε_τ)+1/(β_τ)-1=1.65

对碳钢， φ_σ ≈0.1~0.2 ，取 φ_σ =0.1 ， φ_τ ≈0.05~0.1 ，取 φ_τ =0.05 ，于是，计算安全系数 S_(ca) 值

S_σ =(σ_(-1))/(K_σ σ_a +φ_σ σ_m)=19.02

S_τ =(τ_(-1))/(K_τ τ_a +φ_τ τ_m)=25.50

S_(ca) =(S_σ S_τ)/(√(S_σ^2 +S_τ^2))=31.81≫S=1.5

故截面5左侧校核安全。

#### 5.9.3.2 输出轴截面5右侧精确校核（过盈配合）

抗弯截面系数

W=(πd^3)/32=26214.4 mm^3

抗扭截面系数

W_T =(πd^3)/16=52428.8 mm^3

截面3左侧的弯矩为 M=115.1N∙mm ，所以截面上的弯曲应力为

σ_b =M/W=3.87 MPa

截面上的扭转切应力为

τ_T =T/(W_T)=7.15 MPa

过盈配合处的 (k_σ)/(ε_σ) ，由附表3-8用插值法求出，并取 (k_τ)/(ε_τ)=0.8(k_σ)/(ε_σ) ，于是得

(k_σ)/(ε_σ)=3.31，(k_τ)/(ε_τ)=2.64

轴按磨削加工，由附图3-4查得表面质量系数为

β_σ =β_τ =0.92

故可得综合系数为

K_σ =(k_σ)/(ε_σ)+1/(β_σ)-1=3.40

K_τ =(k_τ)/(ε_τ)+1/(β_τ)-1=2.73

所以轴在截面4左侧的安全系数为

S_σ =(σ_(-1))/(K_σ σ_a +φ_σ σ_m)=15.56

S_τ =(τ_(-1))/(K_τ τ_a +φ_τ τ_m)=11.62

S_(ca) =(S_σ S_τ)/(√(S_σ^2 +S_τ^2))=11.56≫S=1.5

故可知输出轴安全。

# 6 箱体的设计

## 6.1 箱体尺寸设计

根据《机械设计课程设计》表 4-1，箱体的主要尺寸如下表所示。

名称 | 公式 | 结果
箱座壁厚 | δ=0.025a+∆≥8 | 8
箱盖壁厚 | δ_1 =0.02a+∆≥8 | 8
箱座凸缘厚度 | b=1.5δ | 12
箱盖凸缘厚度 | b_1 =1.5δ_1 | 12
底座凸缘厚度 | b_2 =2.5δ | 20
箱座加强肋厚 | m=0.85δ | 6.8
箱盖加强肋厚 | m_1 =0.85δ_1 | 6.8

## 6.2 连接件的选择

由公式 d_f =0.018(d_(m1) +d_(m2) )+1≥12 ，选择地脚螺栓直径为M12，所以轴承旁连接螺栓直径为 d_1 =0.75d_f ，选择为M10。箱盖、箱座连接螺栓栓直径为 d_2 =(0.5~0.6)d_f ，所以选择箱盖、箱座连接螺栓直径为M8。考虑各螺栓的安装尺寸，并留出扳手空间，可设计出箱体底座凸缘、轴承座凸台以及箱盖、箱座连接处凸缘的尺寸。

## 6.3 减速器附件设计

### 6.3.1 窥视孔和视孔盖

为了便于检查箱内传动零件的啮合情况，以及将润滑油注入箱内，在减速器箱盖顶部设置窥视孔，其大小以手能伸入箱体内进行检查操作为宜。为防止润滑油飞溅出来和污物进入箱内，在窥视孔上设置视孔盖，视孔盖下应加防渗漏的垫片。

S_(ca) =31.81

S_(ca) =11.56

装 订 线 | 设计计算及说明 | 主要结果

### 6.3.2 通气器

减速器工作时，由于箱内温度升高，气体膨胀，箱内气压增大。为了避免由此引起密封部位的密封性下降，造成润滑油向外渗漏，在视孔盖上设通气器，使箱内的热膨胀气体能自由地排出，保持箱内外压力平衡，从而保证箱体的密封性。考虑工作环境中可能存在较多的灰尘，通气器选择使用有过滤灰尘作用的网式通气器。

### 6.3.3 油面指示器

为方便检查减速器内部油面的高度，以保证传动件的润滑，在箱体上便于观察、油面较稳定的部位设置压配式圆形游标，以便能在不停车的情况下随时检查油面。

### 6.3.4 放油孔和螺塞

换油时，为了排放污油和清洗剂，应在箱体底部、油池的最低位置处开设放油孔，平时放油孔用带有细牙螺纹的外六角油塞堵住。放油螺塞和箱体结合面间应加防漏用的垫圈。为避免出现半边螺孔，应在箱体内部放油孔前开有凹槽，以避免出现加工螺纹时工艺性较差的问题。

### 6.3.5 起吊装置

为了便于减速器的搬运和装卸，分别在箱盖和箱座上设置吊耳。当减速器重量较小时，箱盖上的吊耳允许用来吊运整个减速器。当减速器重量较大时，箱盖上的吊耳只允许吊运箱盖，而箱座上的吊耳可用来吊运下箱座或整个减速器。

### 6.3.6 起盖螺钉

为了保证减速器的密封性，通常在装配时于箱体剖分面上涂上水玻璃或密封胶，而在拆卸时则因胶结紧密造成困难。为此在箱盖连接凸缘的适当位置，加工出1个螺纹孔，旋入起盖螺钉将箱盖顶起。起盖螺钉的直径与箱体凸缘连接螺栓的直径相同，并与连接螺栓布置在同一直线上，便于钻孔。起盖螺钉端部应制成圆柱形并光滑倒角或半球形，以免反复拧动时损坏螺钉端部螺纹。螺钉材料为35号优质碳素结构钢并通过热处理使硬度达到28-38HRC。

装 订 线 | 设计计算及说明 | 主要结果

### 6.3.7 定位销

为了精确地加工轴承座孔并保证每次拆装后，仍保持轴承座孔的制造精度，需在箱盖和箱座的连接凸缘上配装两个定位销。应使两定位销到箱体对称轴线的距离不等，并尽量远些，以提高定位精度。

### 6.4 减速器的润滑

由前可知，减速器齿轮应采用浸油润滑，对于安装于箱体上的轴承则可以采用飞溅润滑。为此，应在箱座凸缘面上开设导油沟，使飞溅到箱盖内壁上的油经导油沟进入轴承。而对于箱体内部轴承座上的轴承，则可以采用滴油润滑的方法实现连续供油。

# 7 维修养护的设计和技术要求

1、装配前所有零件均应清除铁屑并用煤油或汽油清洗，箱体内不应有任何杂物存在，箱体内壁及零件的不加工表面应涂上防锈油漆；

2、在安装轴承的过程中，应当保证一定的轴向游隙；

3、传动零件侧隙的检查可以用塞尺或铅丝塞进相互啮合的两齿的侧隙中，然后测量塞尺的厚度或者铅丝变形之后的厚度，接触斑点的检查，通常是在主动轮齿面上涂色，当主动轮轻微地转2-3周后，观察从动齿面的着色情况，分析接触区的位置和接触面积的大小，看其是否符合精度要求。当接触斑点没能达到精度要求时，应该调整传动件的啮合位置，或对齿面进行适当的刮研及进行负载跑和以提高装配的精度；

4、润滑油应装至油面规定高度，经常检查及时更换，一般更换时间为半年左右，具体更换时间根据油中杂质的多少及氧化、污染的程度确定；

5、减速器的所有连接面和密封处均不许漏油、渗油。箱体剖分面上允许涂抹密封胶或水玻璃，不允许使用任何垫片；

6、减速器装配完毕之后，在出厂前一般要进行空载试验和整机性能试验，根据工作和产品规范，可选择抽样或全部产品试验；

7、减速器应根据要求，在箱体表面涂上相应的颜色。轴的外伸端及各附件应涂油包装。运输用的减速器包装箱应牢固可靠，装卸时不可倒置，安装搬运时不得使用箱盖上的吊环螺钉。包装箱外应写明“不可倒置”、“防雨淋”等字样。

# 8 参考文献

[1] 濮良贵，陈国定，吴立言. 机械设计[M]. 北京：高等教育出版社，2013.5
[2] 李兴华. 机械设计课程设计[M]. 北京：清华大学出版社，2012.4
[3] 何铭新，钱可强，徐祖茂. 机械制图[M]. 北京：高等教育出版社，2010.7
[4] 成大先，王德夫，姜勇.机械设计手册[M].北京：化学工业出版社，1993.1
[5] 中国机械工程学会，中国机械设计大典编委会.中国机械设计大典[M].南昌：江西科学技术出版社，2002.1

# 9 设计心得

经过两周左右的机械设计实习经历，我初步熟悉了一个较为完整的工作机器——圆锥圆柱齿轮两级减速器的设计基本流程，实现了从简单的书本上的对各零部件的分析，到把电动机、传动部分的设计联系起来的进步。我深刻体会到，机械的设计过程，不仅要满足一定的功能需求，还要保证产品的可靠度和使用年限。只有保持踏实严谨的态度，反复计算与校核，才能保证产品的安全性，避免损失。

设计过程中，由于经验的缺乏，对零件的特性、参数不是很熟悉，也走了许多弯路，犯了许多错误。比如锥齿轮的几何参数计算，轴与联轴器的配合等等。总结出的经验是，设计要严格按照标准来，一步一步按照流程设计，许多参数之间相互关联，不能独立设计。电动机的选择会直接影响传动比大小，从而改变传动件齿轮的参数设计，进而影响轴的受力和轴承选择等等。因此，需要逐步、全面地考虑问题，设计出合格的产品。
