Pinocchio01/AutoCAD/机械设计实习/zhou1.jpg

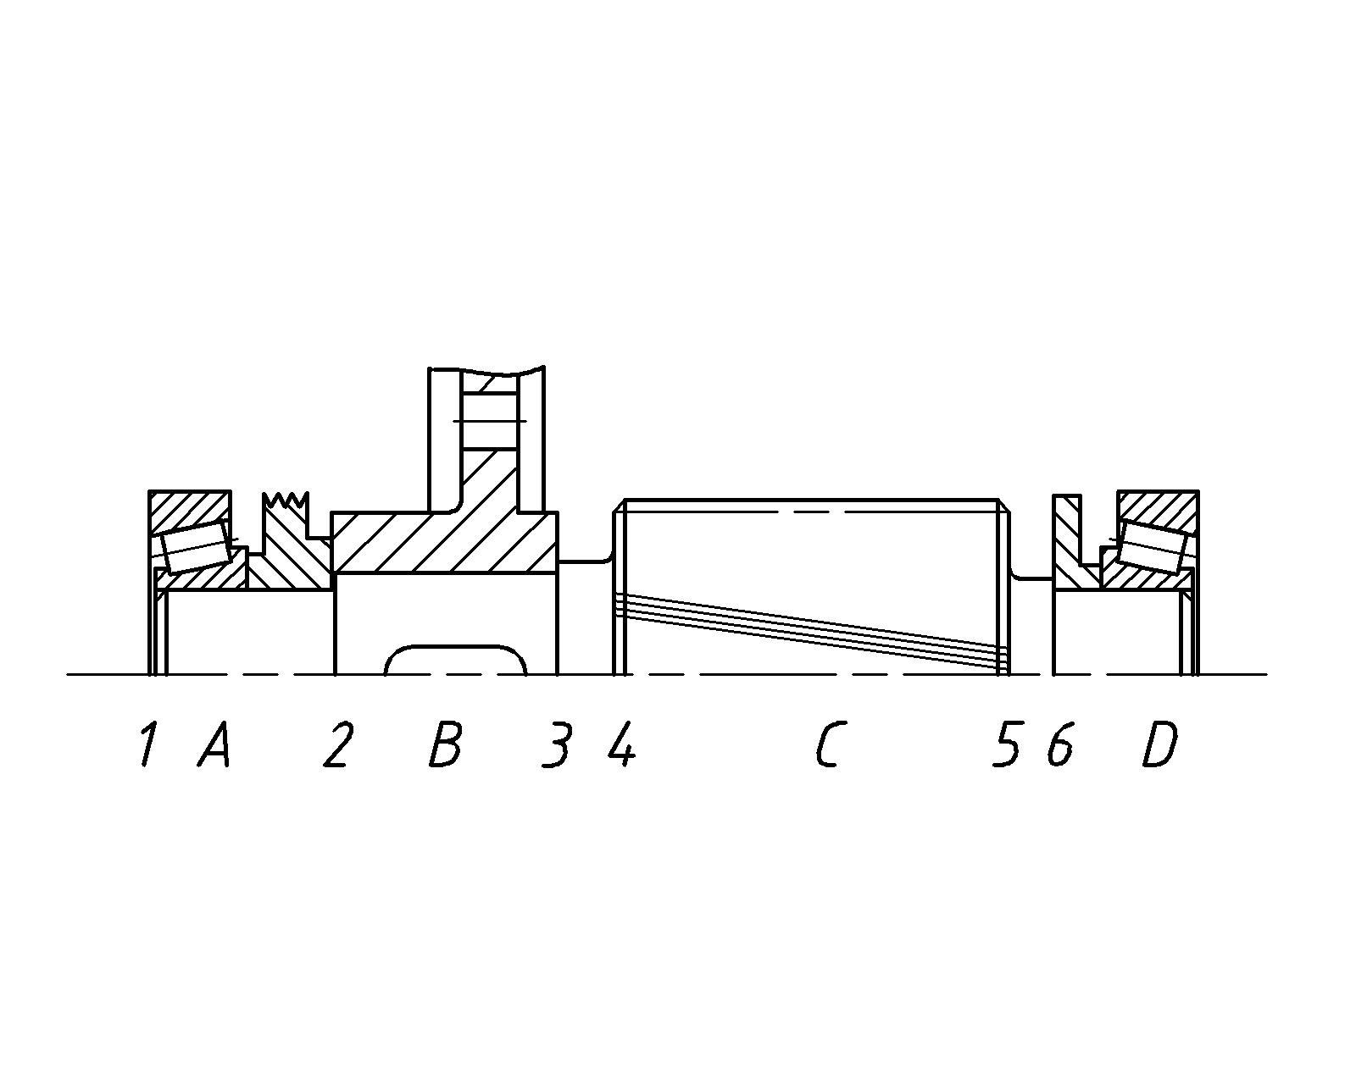
机械设计实习/zhou1.jpg
