Pinocchio01/AutoCAD/机械设计实习/zhou3.jpg

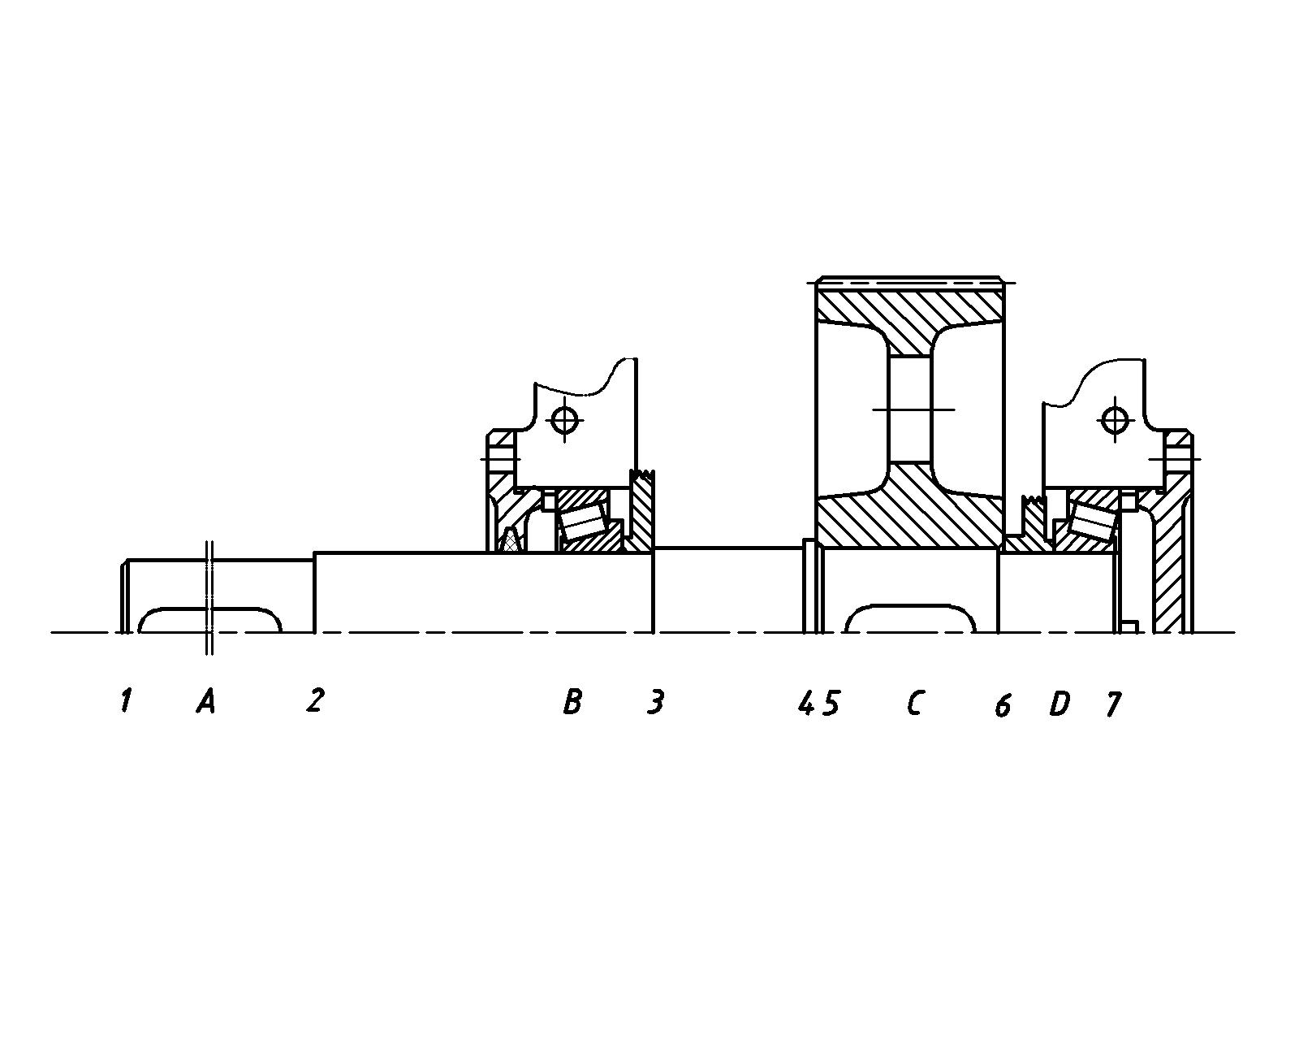
机械设计实习/zhou3.jpg
