Pinocchio01/AutoCAD/机械设计实习/中间轴受力.jpg

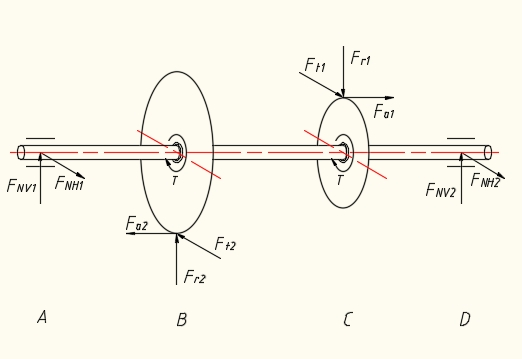
机械设计实习/中间轴受力.jpg
