Pinocchio01/AutoCAD/机械设计实习/输出轴受力.jpg

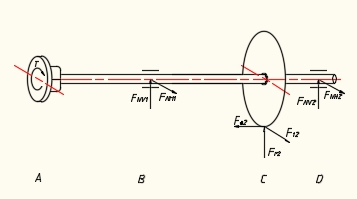
机械设计实习/输出轴受力.jpg
