Pinocchio01/AutoCAD/机械设计实习/输出轴弯扭校核_1.jpg

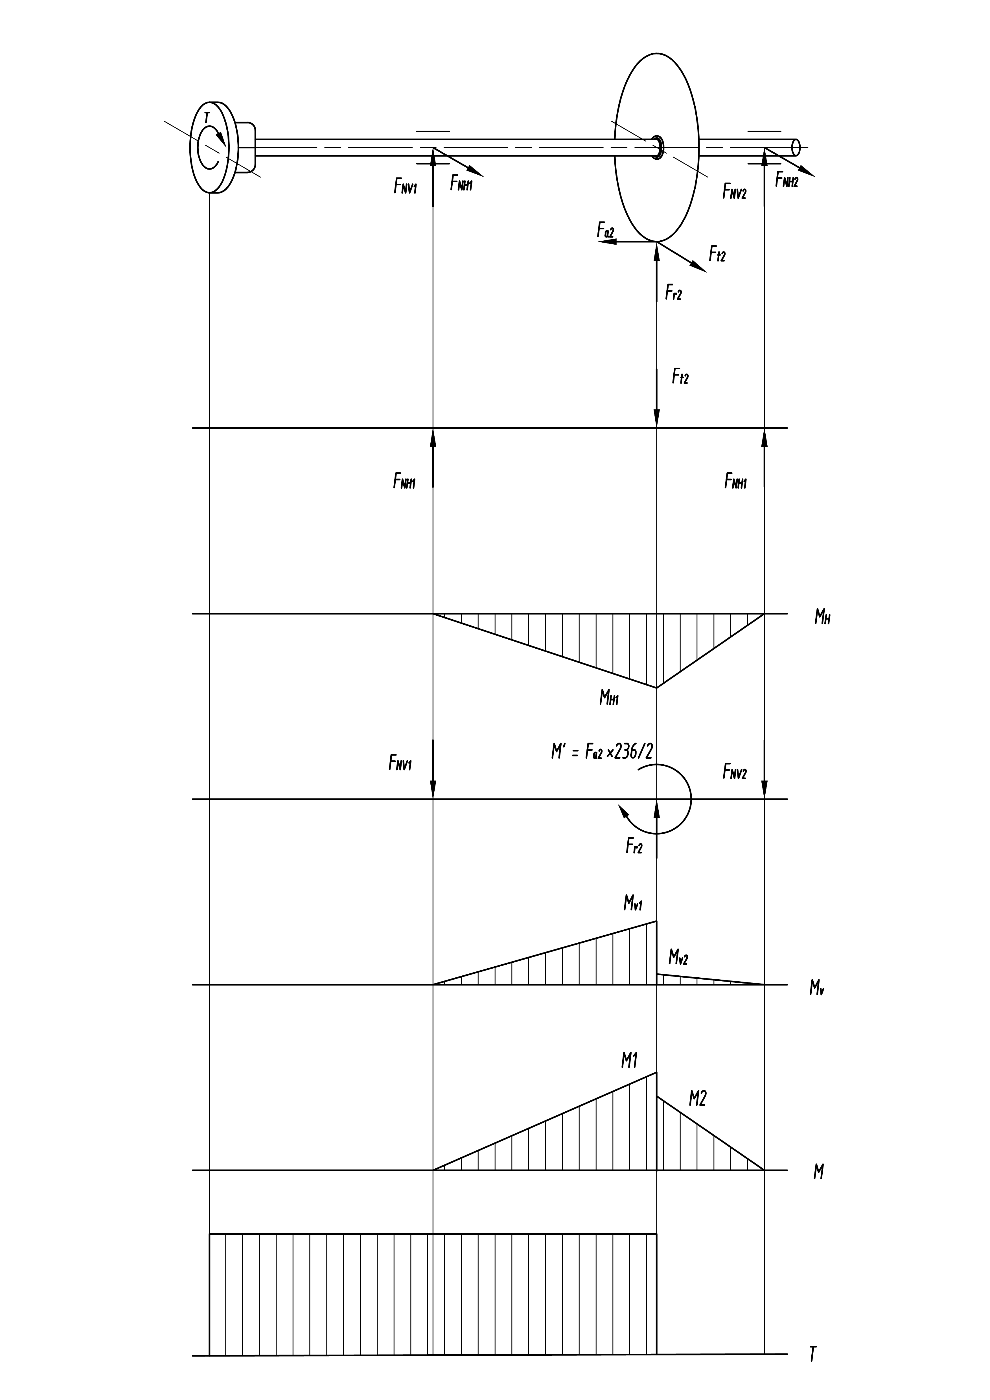
机械设计实习/输出轴弯扭校核_1.jpg
