Pinocchio01/AutoCAD/机械设计实习/高速轴受力.jpg

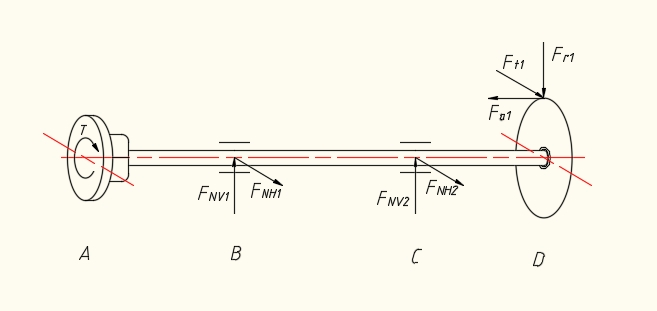
机械设计实习/高速轴受力.jpg
