Pinocchio01/AutoCAD/机械设计实习/低速轴.pdf

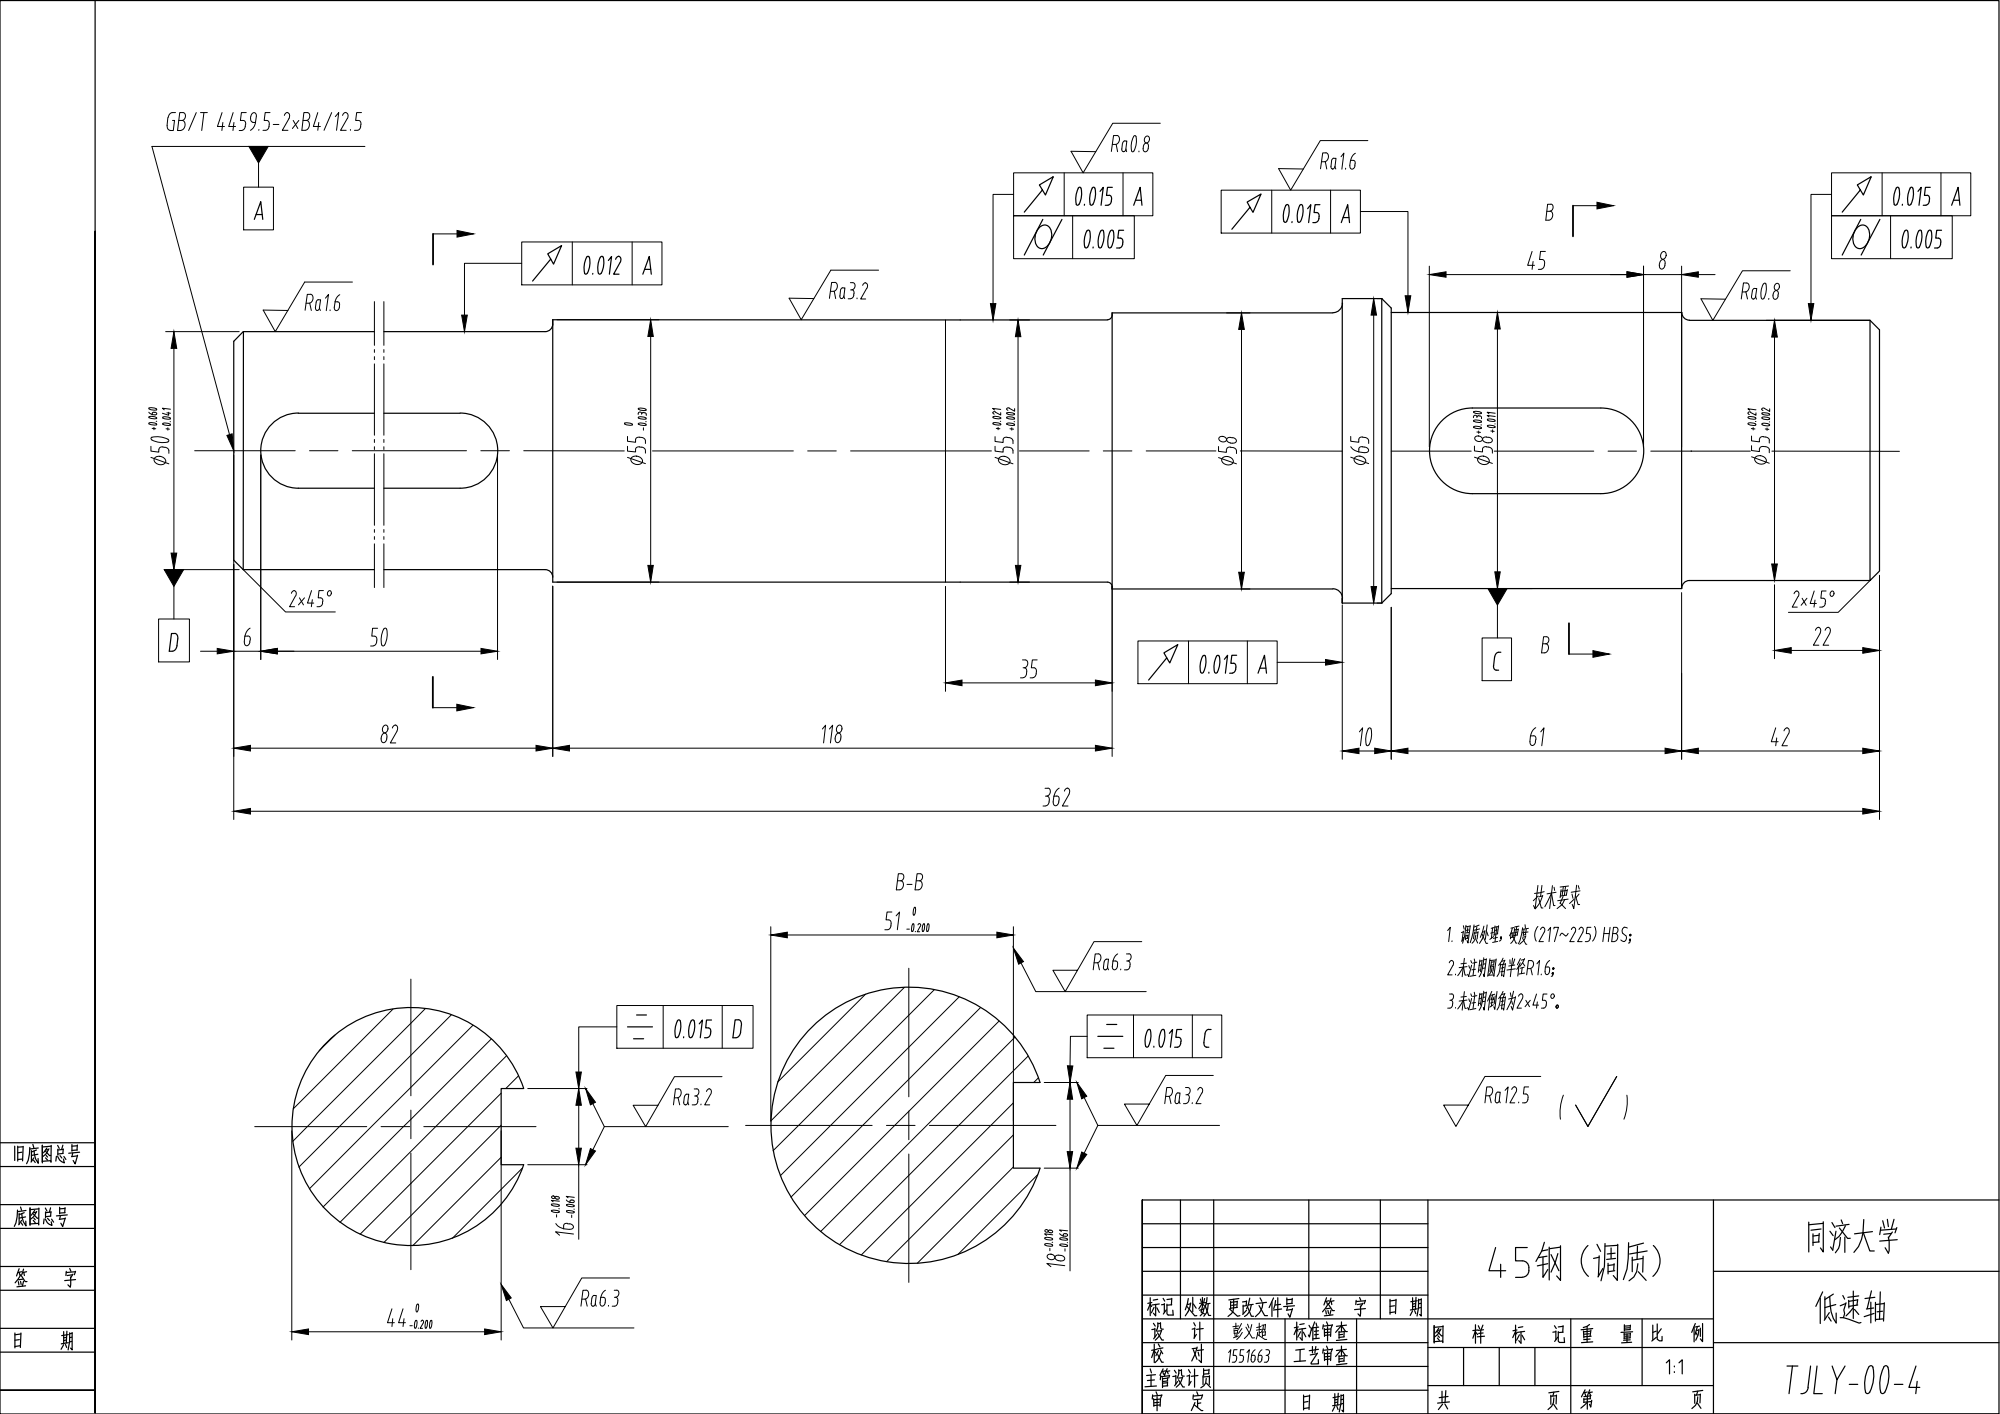
[picture p22: page 1]
