Pinocchio01/AutoCAD/机械设计实习/低速轴大齿轮.pdf

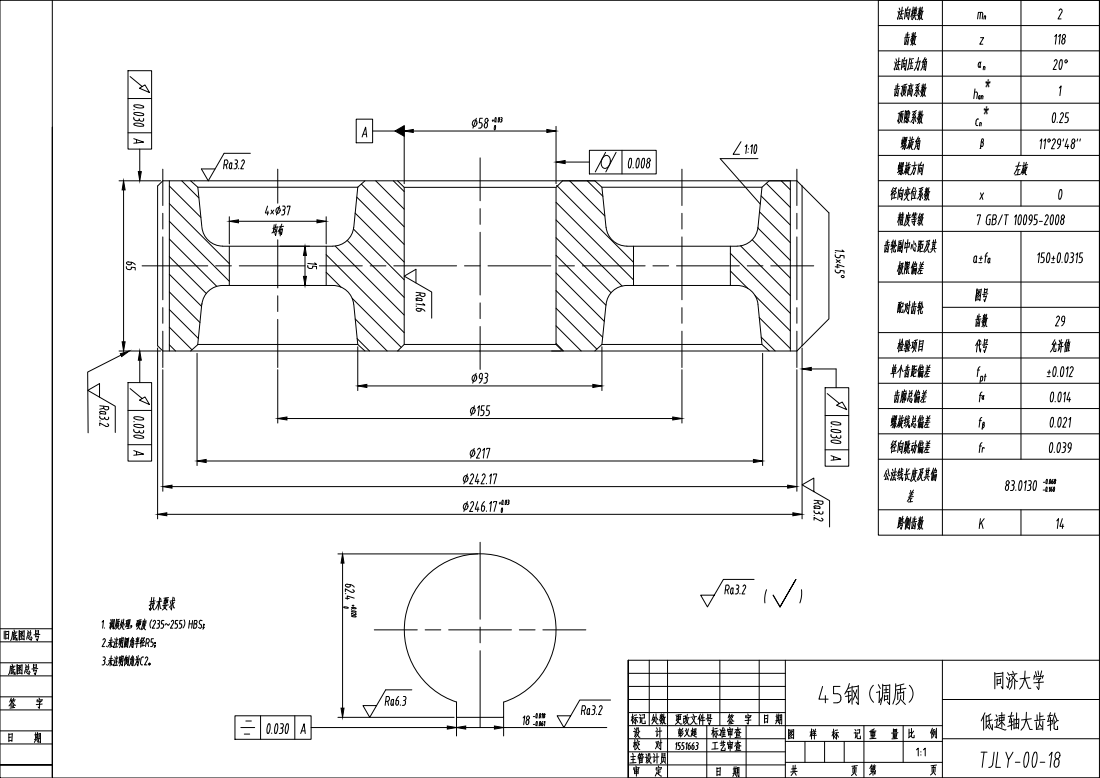
[picture p23: page 1]
