Pinocchio01/AutoCAD/机械设计实习/减速箱 彭义超 1551663.pdf

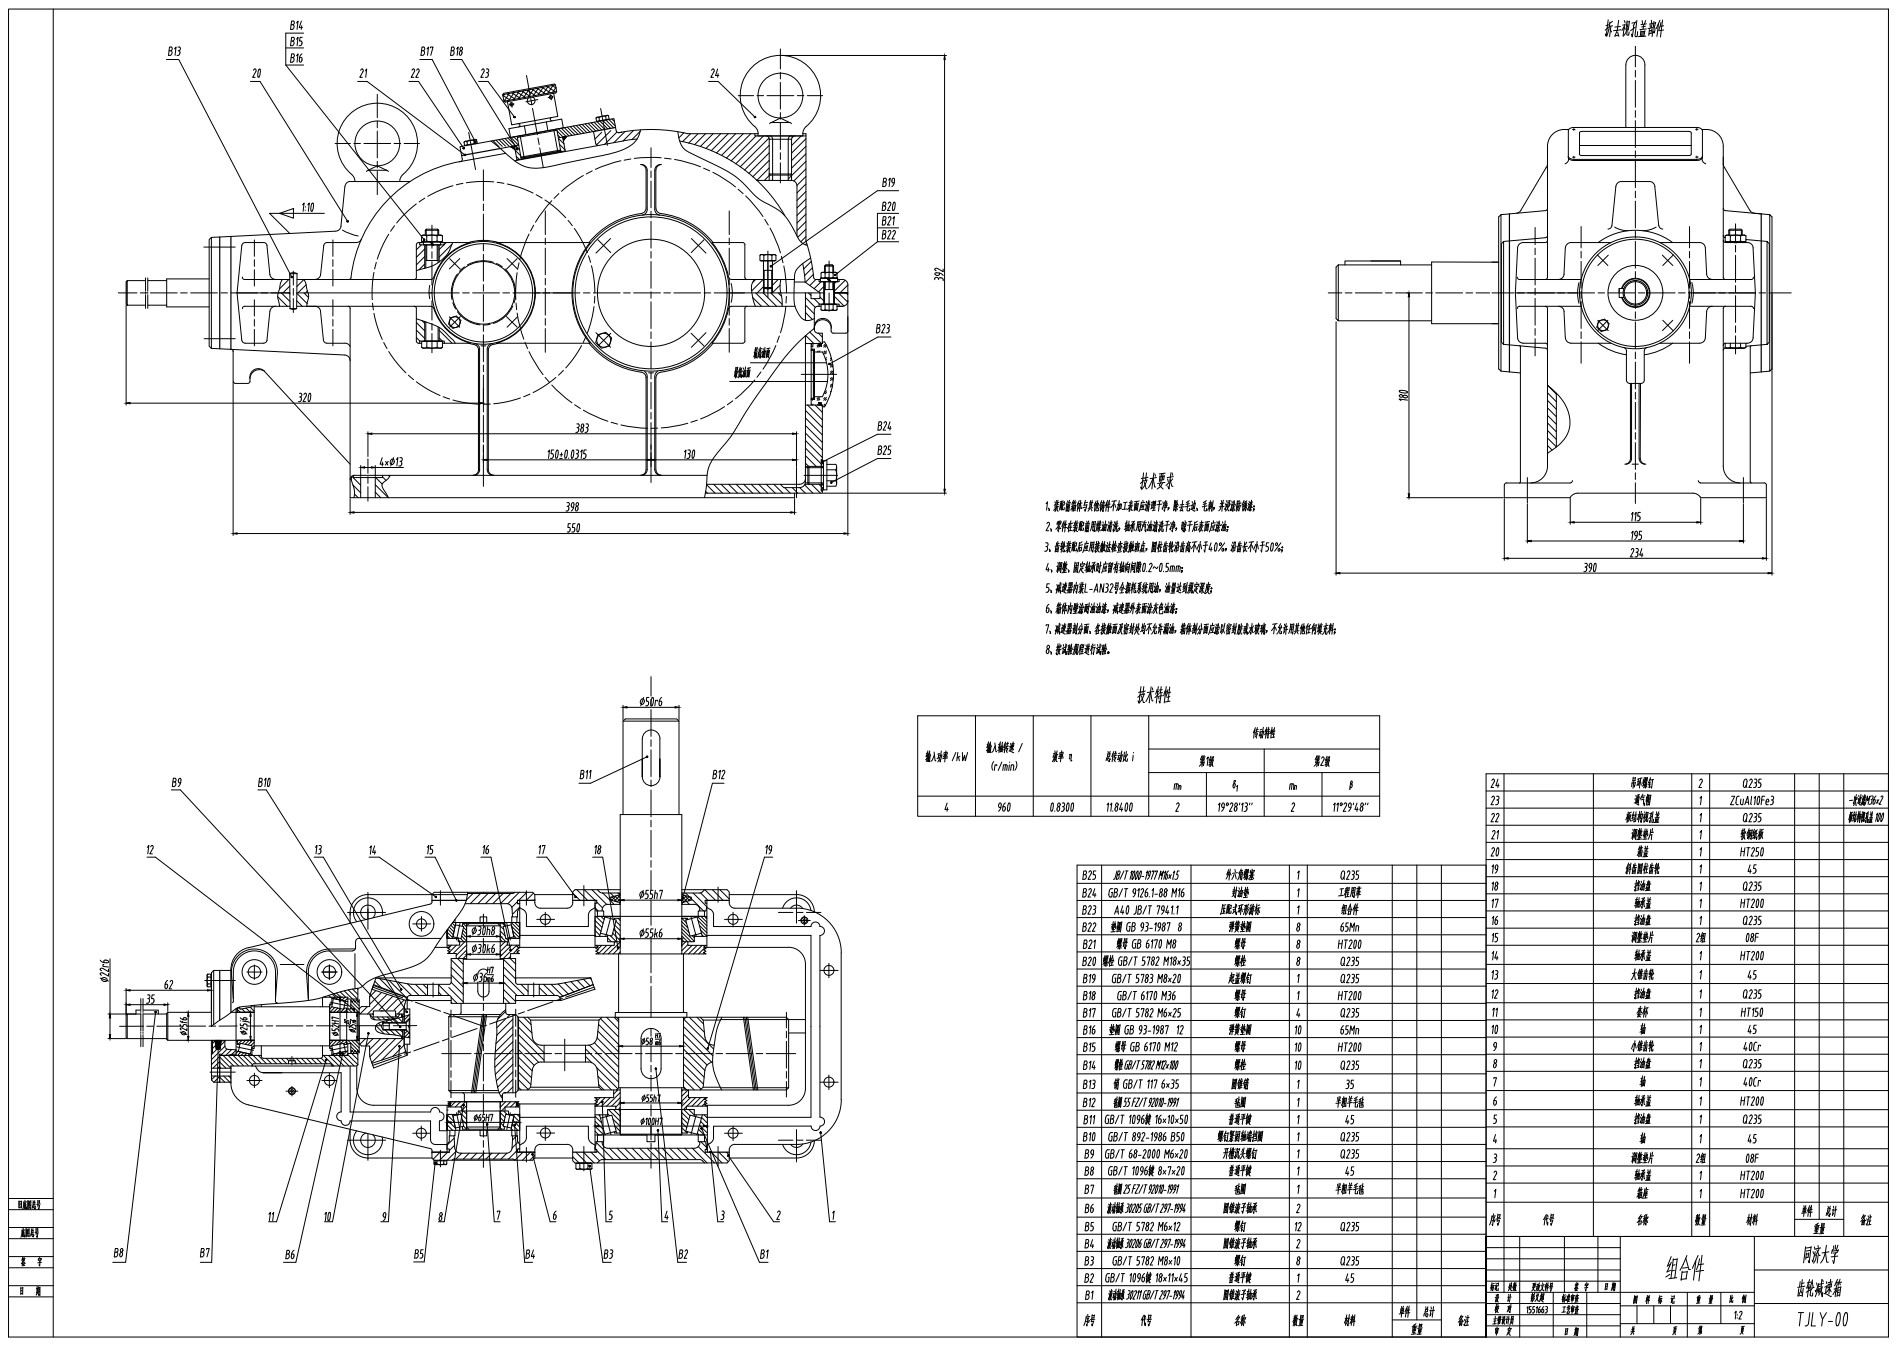
[picture p24: page 1]
