Pinocchio01/AutoCAD/(list of files, cad)

Other CAD files:
机械设计实习/装配图Entwurf.dwg
机械设计实习/减速箱零件图.dwg
